thedarknet/dc26-badge/README.md

# dc26-badge
Darknet Industries Badge for Defcon 26

Firmware directory has STM32 and ESP32 firmware

hardware has:

* Darknet dc 26 eagle component library library
* Eagle files for board design
* docs for all components on the board plus a number of others that were considered
