thedarknet/dc26-badge/hardware/devboard/dc26-dev-board/README.md

The darknet board for 2018 (darknet-7) was dc26.brd/sch.
* Things I have not fixed yet:
 * The standard 3mm LEDs are backwards.
