thedarknet/dc26-badge/firmware/esp-wroom-32/dc26-esp/README.md

### DarkNet 7 ESP WROOM 32 code

First thing is to thank nkolban for his book, for his great code snippets.
https://github.com/nkolban/esp32-snippets.git

If you working on ESP get his book:  https://leanpub.com/kolban-ESP32
