thedarknet/dc26-badge/firmware/DevBoard/darknet-7/chipinfo.txt

> flash info 0
device id = 0x10006431
flash size = 512kbytes
#0 : stm32f2x at 0x08000000, size 0x00080000, buswidth 0, chipwidth 0
        #  0: 0x00000000 (0x4000 16kB) not protected
        #  1: 0x00004000 (0x4000 16kB) not protected
        #  2: 0x00008000 (0x4000 16kB) not protected
        #  3: 0x0000c000 (0x4000 16kB) not protected
        #  4: 0x00010000 (0x10000 64kB) not protected
        #  5: 0x00020000 (0x20000 128kB) not protected
        #  6: 0x00040000 (0x20000 128kB) not protected
        #  7: 0x00060000 (0x20000 128kB) not protected
STM32F4xx (Low Power) - Rev: A
