thedarknet/dc26-badge/firmware/DevBoard/darknet-7/Src/darknet/art/dc_zia_128-sized.png

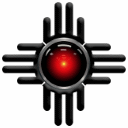
firmware/DevBoard/darknet-7/Src/darknet/art/dc_zia_128-sized.png
