thedarknet/dc26-badge/firmware/DevBoard/darknet-7/Src/darknet/art/TITS.png

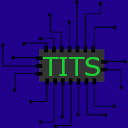
firmware/DevBoard/darknet-7/Src/darknet/art/TITS.png
