thedarknet/dc26-badge/firmware/esp-wroom-32/dc26-esp/main/dc26_ble/ESP WROOM 32-Interaction.png

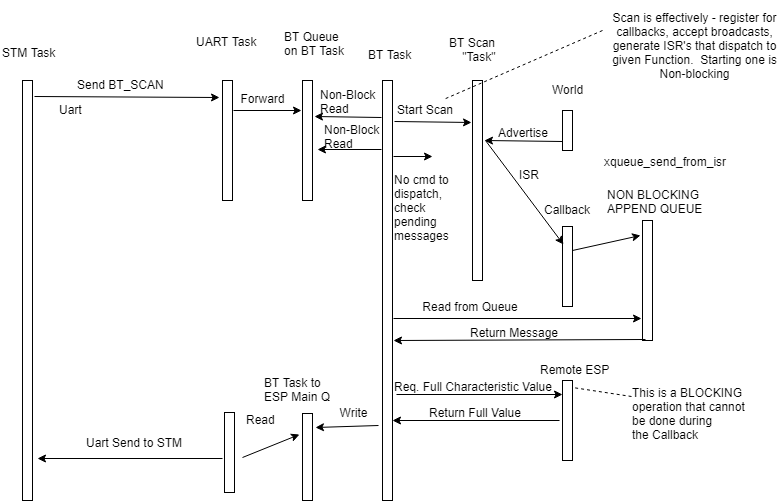
firmware/esp-wroom-32/dc26-esp/main/dc26_ble/ESP WROOM 32-Interaction.png
