thedarknet/dc26-badge/hardware/docs/led-symbols.jpg

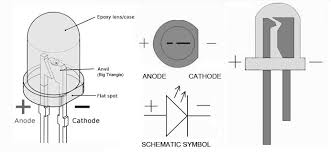
hardware/docs/led-symbols.jpg
