thedarknet/dc26-badge/hardware/docs/LEDs-2.PNG

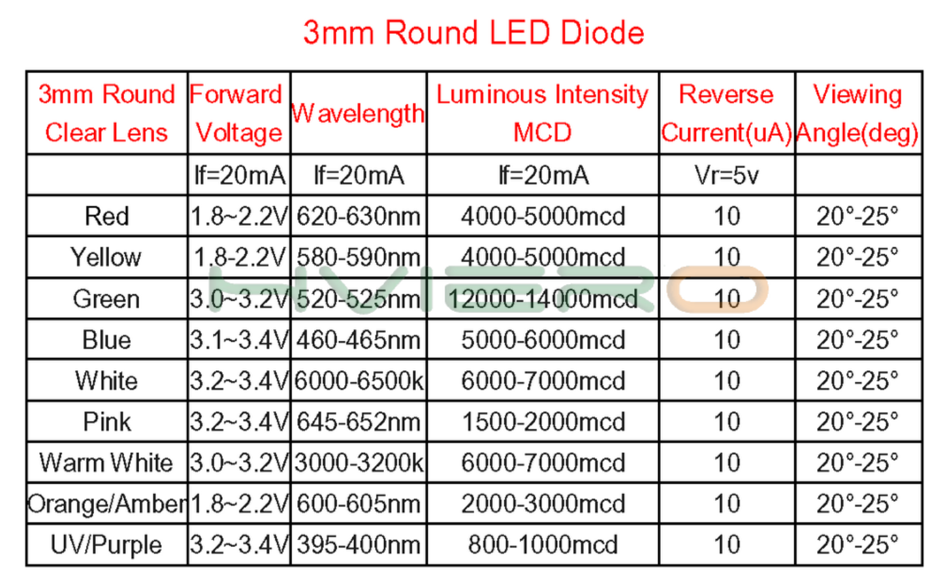
hardware/docs/LEDs-2.PNG
