thedarknet/dc26-badge/hardware/docs/LEDs.PNG

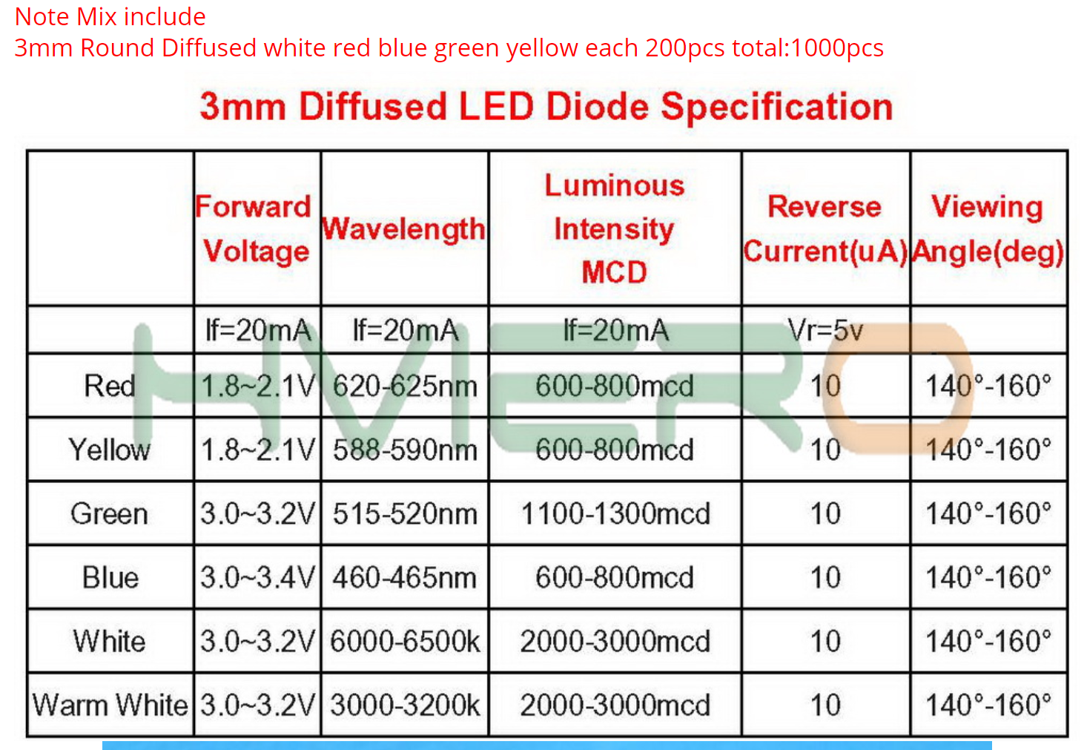
hardware/docs/LEDs.PNG
