thedarknet/dc26-badge/hardware/docs/SSSS8 Series - Basic information_files/Reel38_W.GIF

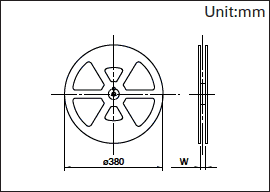
hardware/docs/SSSS8 Series - Basic information_files/Reel38_W.GIF
