thedarknet/dc26-badge/hardware/docs/SSSS8 Series - Basic information_files/SLIDE_H.GIF

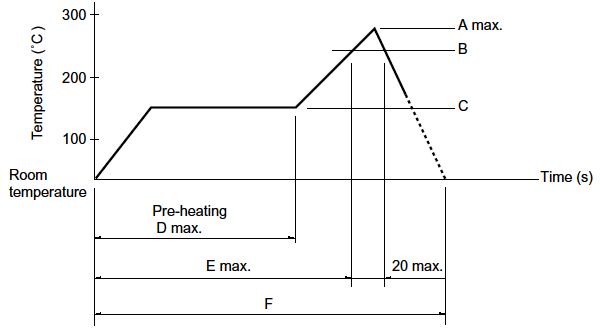
hardware/docs/SSSS8 Series - Basic information_files/SLIDE_H.GIF
