thedarknet/dc26-badge/hardware/docs/SSSS8 Series - Basic information_files/SSSS8_D_31.GIF

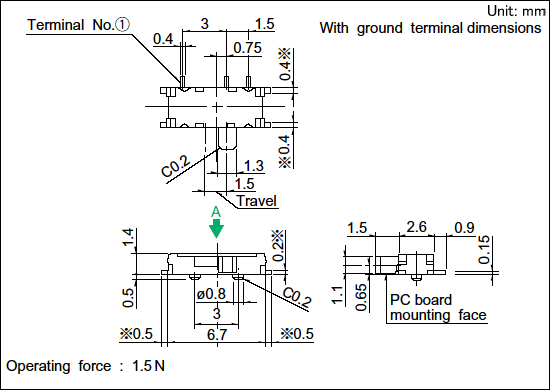
hardware/docs/SSSS8 Series - Basic information_files/SSSS8_D_31.GIF
