thedarknet/dc26-badge/hardware/docs/SSSS8 Series - Basic information_files/SSSS8_D_32.GIF

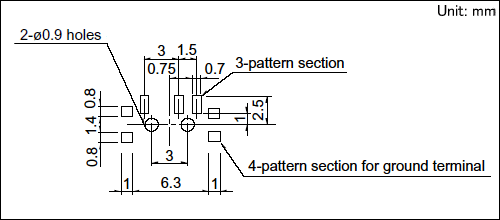
hardware/docs/SSSS8 Series - Basic information_files/SSSS8_D_32.GIF
