thedarknet/dc26-badge/hardware/docs/SSSS8 Series - Basic information_files/SSSS811101.jpg

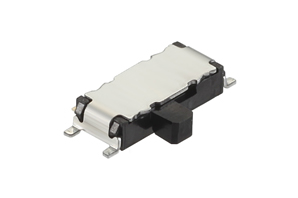
hardware/docs/SSSS8 Series - Basic information_files/SSSS811101.jpg
