thedarknet/dc26-badge/hardware/dc26-sao/eggplant/eggplant-BOM.xls

Sheet: 1
No. | part number/description | Package | Value | Qty | RefDefs | Note | 200sets
1 | ATTINY85-20SUR | SO08-EIAJ |  | 1 | U1 |  | $1.265
2 |  | R-EU_R0603_5MIL_DWS | 10K/5% | 3 | R2, R3, R5 |  | $0.009 | Provide general resistor 10K 0603 1%
3 |  | R-EU_R0805_5MIL_DWS | 0 | 2 | R1, R4 |  | $0.009 | Provide general resistor 0.2R 0805 1%
4 |  | R-EU_R0603_5MIL_DWS | 22/5% | 10 | R6, R7, R8, R9, R10, R11, R12, R13, R14, R15 |  | $0.009 | Provide general resistor 22R 0603 1%
5 | PHBM2012QBDSURKC | 0805 |  | 5 | LED1, LED2, LED3, LED4, LED5
 |  |  |  |  |  |  | 0.5KG
 |  |  |  |  | Total: | 1 set | $1.40
 |  |  |  |  |  | 200 sets | $279.4
 | PCBWay PCB Assembly Service

Sheet: Sheet1
U2 MT9V022I77ATM_ES@IBGA-52
U1 EMP7032SLC44-15@TQFP12FL12-44
J2 HEADER_13X2@CON26
J1 DOWNCABLE@CON10
X1 OSC@KDS-OSC-2025
C2 CAP_NP@CAP0402
C3 CAP_NP@CAP0402
C8 CAP_NP@CAP0402
C5 CAP_NP@CAP0402
C6 CAP_NP@CAP0402
C7 CAP_NP@CAP0402
C10 CAP_NP@CAP0402
C9 CAP_NP@CAP0402
C11 CAPACITOR_POL@SMC3528
C12 CAPACITOR_POL@SMC3528
L3 INDUCTOR@SMC0603
L2 INDUCTOR@SMC0603
C1 CAP_NP@CAP0402
L1 INDUCTOR@SMC0603
C4 CAP_NP@CAP0402
U3 COMPONENT_1@SOT23-5
C15 1-CAP-POL-MY@SMC3528
C16 1-CAP-POL-MY@SMC3528
R1 R@RES0402
R2 R@RES0402
C13 CAPACITOR_POL@SMC3528
U4 COMPONENT_1@SOT23-5
C19 1-CAP-POL-MY@SMC3528
C20 1-CAP-POL-MY@SMC3528
C14 CAP_NP@CAP0402
C17 CAP_NP@CAP0402
C22 CAP_NP@CAP0402
C18 CAP_NP@CAP0402
C21 CAP_NP@CAP0402
C23 CAP_NP@CAP0402
R3 R@RES0402
R4 R@RES0402
