thedarknet/dc26-badge/hardware/dc26-lbr/LDL112D33R/3D/LDL112D33R.stp

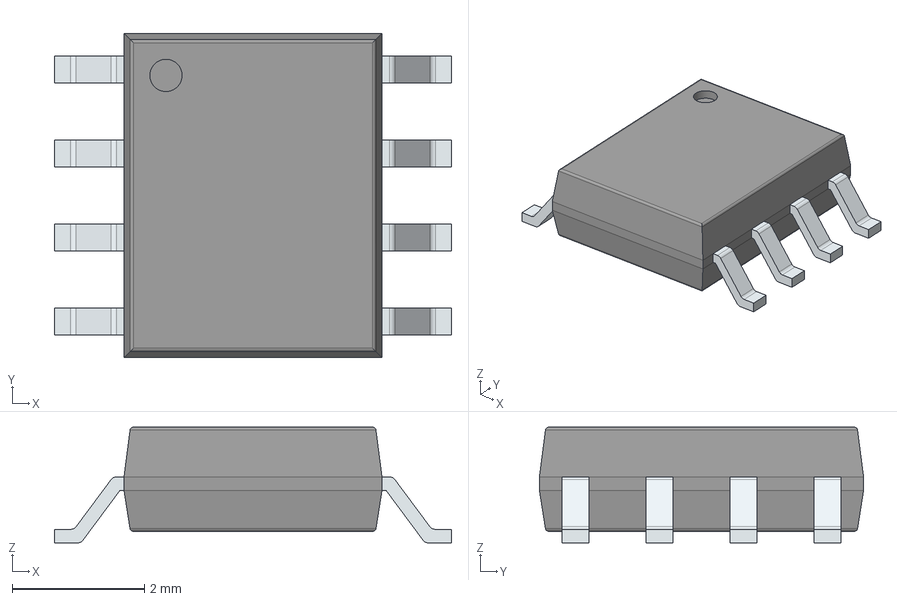
[picture p15: CAD file, 2018-04-17]
hardware/dc26-lbr/LDL112D33R/3D/LDL112D33R.stp
6.00 x 4.90 x 1.75 mm
PinsArrayLR
