thedarknet/dc26-badge/hardware/dc26-lbr/LIB_BLM18TG221TN1D/BLM18TG221TN1D/3D/BLM18TG221TN1D.stp

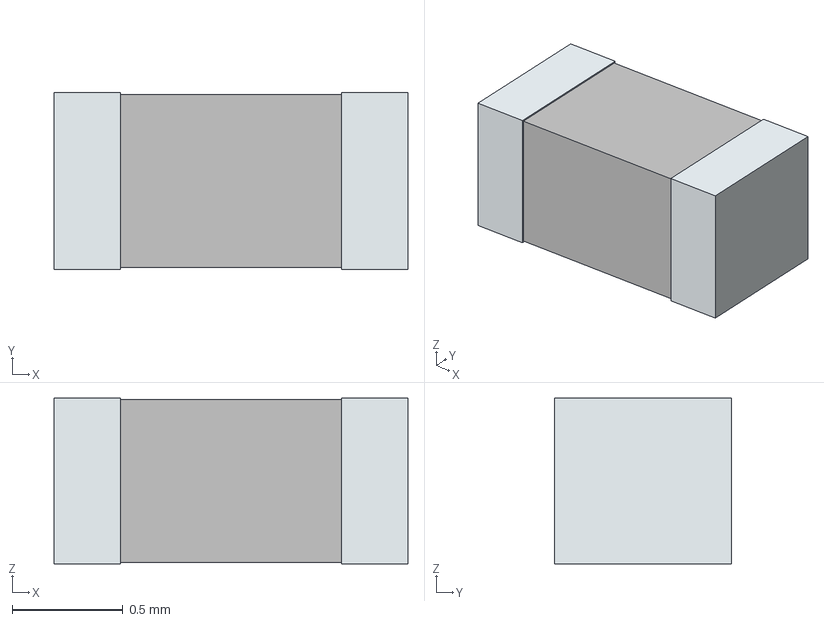
[picture p16: CAD file, 2017-12-29]
hardware/dc26-lbr/LIB_BLM18TG221TN1D/BLM18TG221TN1D/3D/BLM18TG221TN1D.stp
1.60 x 0.8 x 0.75 mm
term1
term2
