thedarknet/dc26-badge/hardware/dc26-lbr/LIB_STM32F411RET6/STM32F411RET6/3D/STM32F411RET6.stp

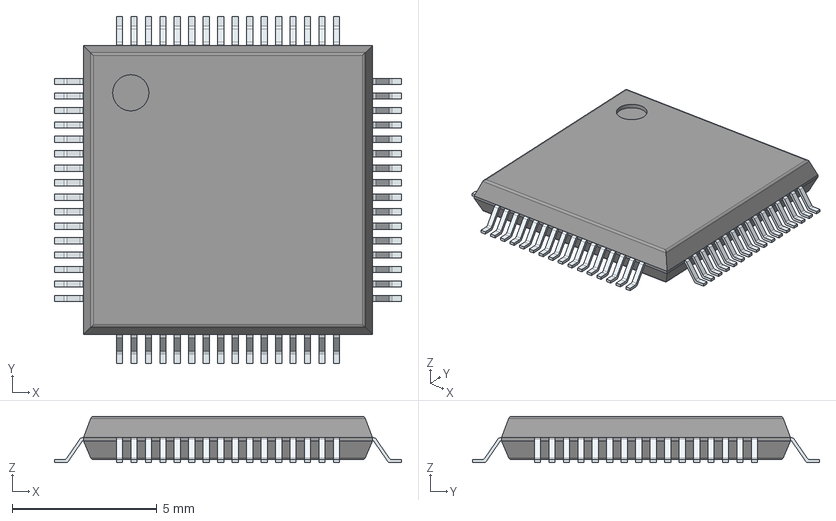
[picture p17: CAD file, 2017-12-07]
hardware/dc26-lbr/LIB_STM32F411RET6/STM32F411RET6/3D/STM32F411RET6.stp
12.0 x 12.0 x 1.60 mm
PinsArrayLR
PinsArrayTB
