thedarknet/dc26-badge/hardware/dc26-lbr/LIB_LD39050PU33R/LD39050PU33R/3D/LD39050PU33R.stp

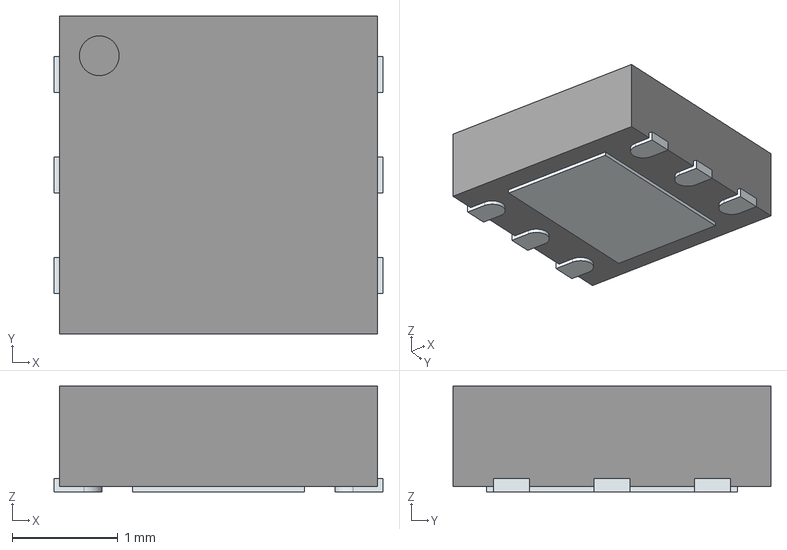
[picture p18: CAD file, 2017-12-31]
hardware/dc26-lbr/LIB_LD39050PU33R/LD39050PU33R/3D/LD39050PU33R.stp
3.10 x 3.00 x 1.00 mm
ThermalPin
PinsArrayLR
