thedarknet/dc26-badge/hardware/dc26-lbr/LIB_LD39100PU33RY/LD39100PU33RY/3D/LD39100PU33RY.stp

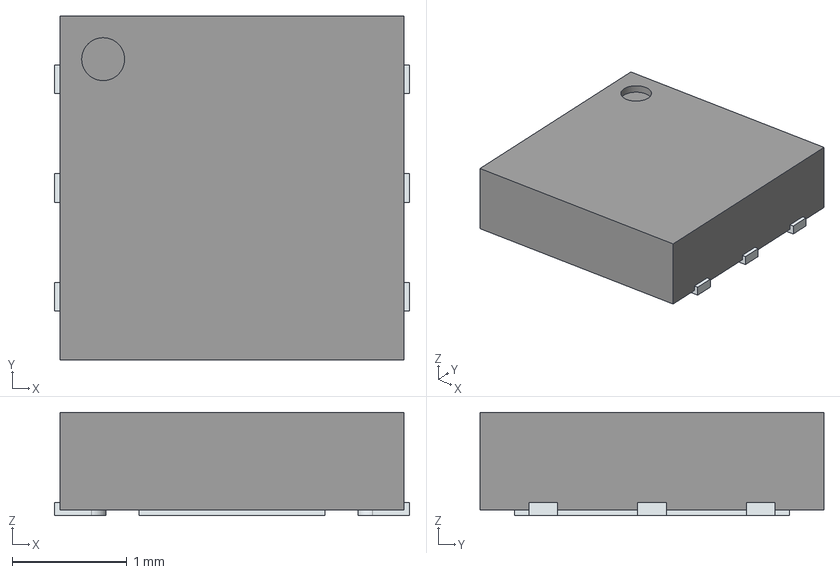
[picture p19: CAD file, 2018-01-01]
hardware/dc26-lbr/LIB_LD39100PU33RY/LD39100PU33RY/3D/LD39100PU33RY.stp
3.10 x 3.00 x 0.9 mm
ThermalPin
PinsArrayLR
