thedarknet/dc26-badge/(list of files, cad)

Other CAD files:
hardware/dc26-lbr/LDL112D33R/3D/LDL112D33R.stl
hardware/dc26-lbr/LIB_BLM18TG221TN1D/BLM18TG221TN1D/3D/BLM18TG221TN1D.stl
hardware/dc26-lbr/LIB_LD39050PU33R/LD39050PU33R/3D/LD39050PU33R.stl
hardware/dc26-lbr/LIB_LD39100PU33RY/LD39100PU33RY/3D/LD39100PU33RY.stl
hardware/dc26-lbr/LIB_STM32F411RET6/STM32F411RET6/3D/STM32F411RET6.stl
