thedarknet/dc26-badge/hardware/dc26-sao/eggplant/eggplant.brd

## EAGLE design hardware/dc26-sao/eggplant/eggplant.brd (2018-07-22)

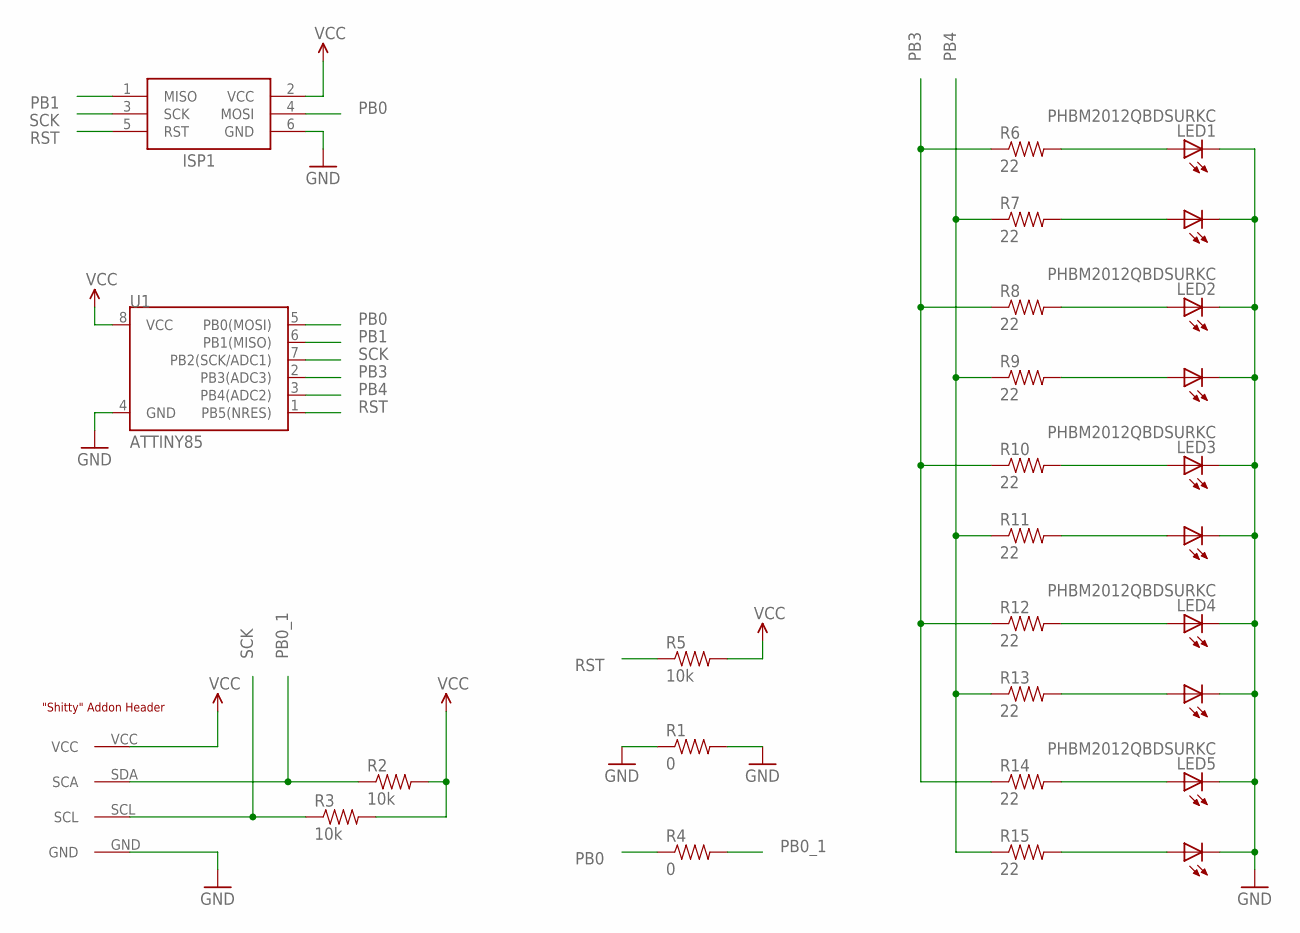
[picture p20: schematic eggplant.sch]

Parts:
ISP1: AVRISPPOGO; AVRISP-POGO
LED1, LED2, LED3, LED4, LED5: PHBM2012QBDSURKC; 0805-DUALLED
R1, R4: 0; 0805
R2, R3, R5: 10k; 0603-RES
R6, R7, R8, R9, R10, R11, R12, R13, R14, R15: 22; 0603-RES
U1: ATTINY85; SO08-EIAJ
U$1: ADDONSC_ADDON_SMD; SC_ADDON_SMD

Connections:
GND: ISP1.6 (GND), LED1.CB (C1), LED1.CR (C2), LED2.CB (C1), LED2.CR (C2), LED3.CB (C1), LED3.CR (C2), LED4.CB (C1), LED4.CR (C2), LED5.CB (C1), LED5.CR (C2), R1.1, R1.2, U1.4 (GND), U$1.GND
unnamed: LED1.AB (A1), R6.2
unnamed: LED1.AR (A2), R7.2
unnamed: LED2.AB (A1), R8.2
unnamed: LED2.AR (A2), R9.2
unnamed: LED3.AB (A1), R10.2
unnamed: LED3.AR (A2), R11.2
unnamed: LED4.AB (A1), R12.2
unnamed: LED4.AR (A2), R13.2
unnamed: LED5.AB (A1), R14.2
unnamed: LED5.AR (A2), R15.2
PB0: ISP1.4 (MOSI), R4.1, U1.5 (PB0(MOSI))
PB0_1: R2.1, R4.2, U$1.SDA (SCA)
PB1: ISP1.1 (MISO), U1.6 (PB1(MISO))
PB3: R6.1, R8.1, R10.1, R12.1, R14.1, U1.2 (PB3(ADC3))
PB4: R7.1, R9.1, R11.1, R13.1, R15.1, U1.3 (PB4(ADC2))
RST: ISP1.5 (RST), R5.1, U1.1 (PB5(NRES))
SCK: ISP1.3 (SCK), R3.1, U1.7 (PB2(SCK/ADC1)), U$1.SCL
VCC: ISP1.2 (VCC), R2.2, R3.2, R5.2, U1.8 (VCC), U$1.VCC

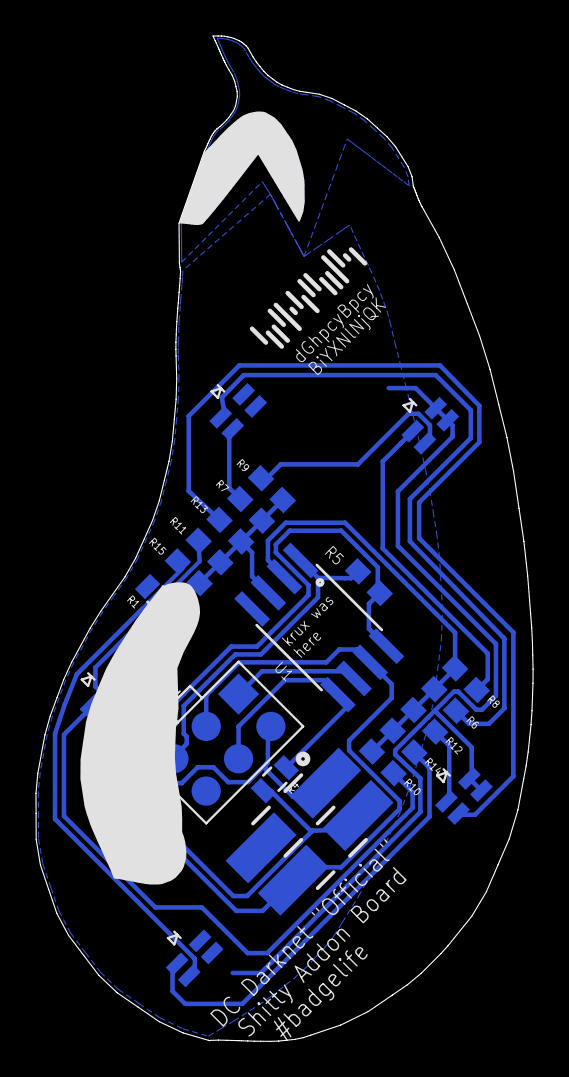
[picture p21: board eggplant.brd from below]

Board: 2 copper layers, 27.6 x 55.9 mm, 23 parts (22 on the bottom side), 19 nets.
