thedarknet/dc26-badge/hardware/devboard/dc26-dev-board/dc26.brd

## EAGLE design hardware/devboard/dc26-dev-board/dc26.brd (2018-06-18)

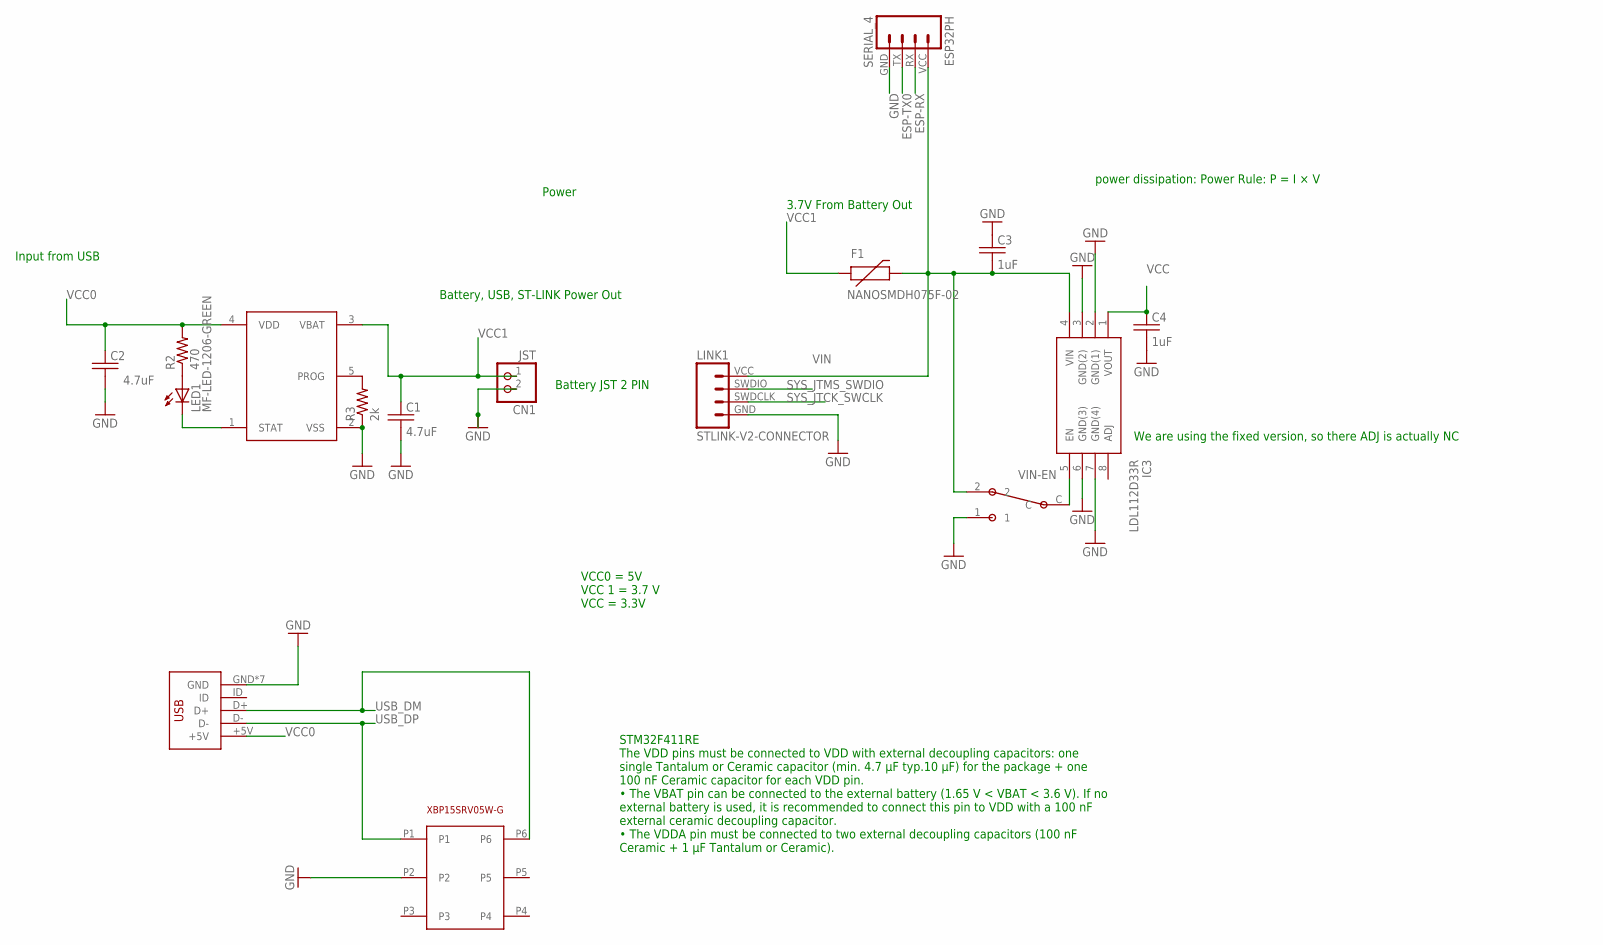
[picture p22: schematic dc26.sch, sheet 1]

Parts:
C1, C2: 4.7uF; C0805
C3, C4: 1uF; C0805
CHARGE: MCP73831; SOT23-5
CN1: JST; JST-PH-2-THM-RA
ESP32PH: SERIAL_4; SERIAL_HEADER_4
F1: NANOSMDH075F-02; PTC-1206
IC3: LDL112D33R; SOIC127P600X175-8N
LED1: MF-LED-1206-GREEN; LED-1206
LINK1: STLINK-V2-CONNECTOR; 1X04
P1: SPDT_SSAJ120100
R2: 470; 0805
R3: 2k; 0805
U$17: XBP15SRV05W-G; SOT-26P-XBP15SRV05W-G
USB: DX4R005JJ2DX4R005JJ2; DX4R005JJ2

Connections:
ESP-RX: ESP32PH.RX; also elsewhere on the board
ESP-TX0: ESP32PH.TX; also elsewhere on the board
GND: C1.2, C2.2, C3.1, C4.2, CHARGE.2 (VSS), CN1.2 (1), ESP32PH.GND, IC3.2 (GND(1)), IC3.3 (GND(2)), IC3.6 (GND(3)), IC3.7 (GND(4)), LINK1.GND, P1.1, R3.1, U$17.P2, USB.GND, USB.P$6 (GND), USB.P$7 (GND), USB.P$8 (GND), USB.P$9 (GND), USB.P$10 (GND), USB.P$11 (GND); also elsewhere on the board
unnamed: LED1.A, R2.1
unnamed: CHARGE.5 (PROG), R3.2
unnamed: CHARGE.1 (STAT), LED1.C
SYS_JTCK_SWCLK: LINK1.SWDCLK; also elsewhere on the board
SYS_JTMS_SWDIO: LINK1.SWDIO; also elsewhere on the board
USB_DM: U$17.P6, USB.D+; also elsewhere on the board
USB_DP: U$17.P1, USB.D-; also elsewhere on the board
VCC: C4.1, IC3.1 (VOUT); also elsewhere on the board
VCC0: C2.1, CHARGE.4 (VDD), R2.2, USB.+5V
VCC1: C1.1, CHARGE.3 (VBAT), CN1.1 (2), F1.1; also elsewhere on the board
VIN: C3.2, ESP32PH.VCC, F1.2, IC3.4 (VIN), LINK1.VCC, P1.2; also elsewhere on the board
VIN-EN: IC3.5 (EN), P1.C; also elsewhere on the board

Notes on the sheet:
Input from USB
Battery JST 2 PIN
Battery, USB, ST-LINK Power Out
power dissipation: Power Rule: P = I × V
3.7V From Battery Out
VCC0 = 5V VCC 1 = 3.7 V VCC = 3.3V
Power
STM32F411RE The VDD pins must be connected to VDD with external decoupling capacitors: one single Tantalum or Ceramic capacitor (min. 4.7 μF typ.10 μF) for the package + one 100 nF Ceramic capacitor for each VDD pin. • The VBAT pin can be connected to the external battery (1.65 V < VBAT < 3.6 V). I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
We are using the fixed version, so there ADJ is actually NC

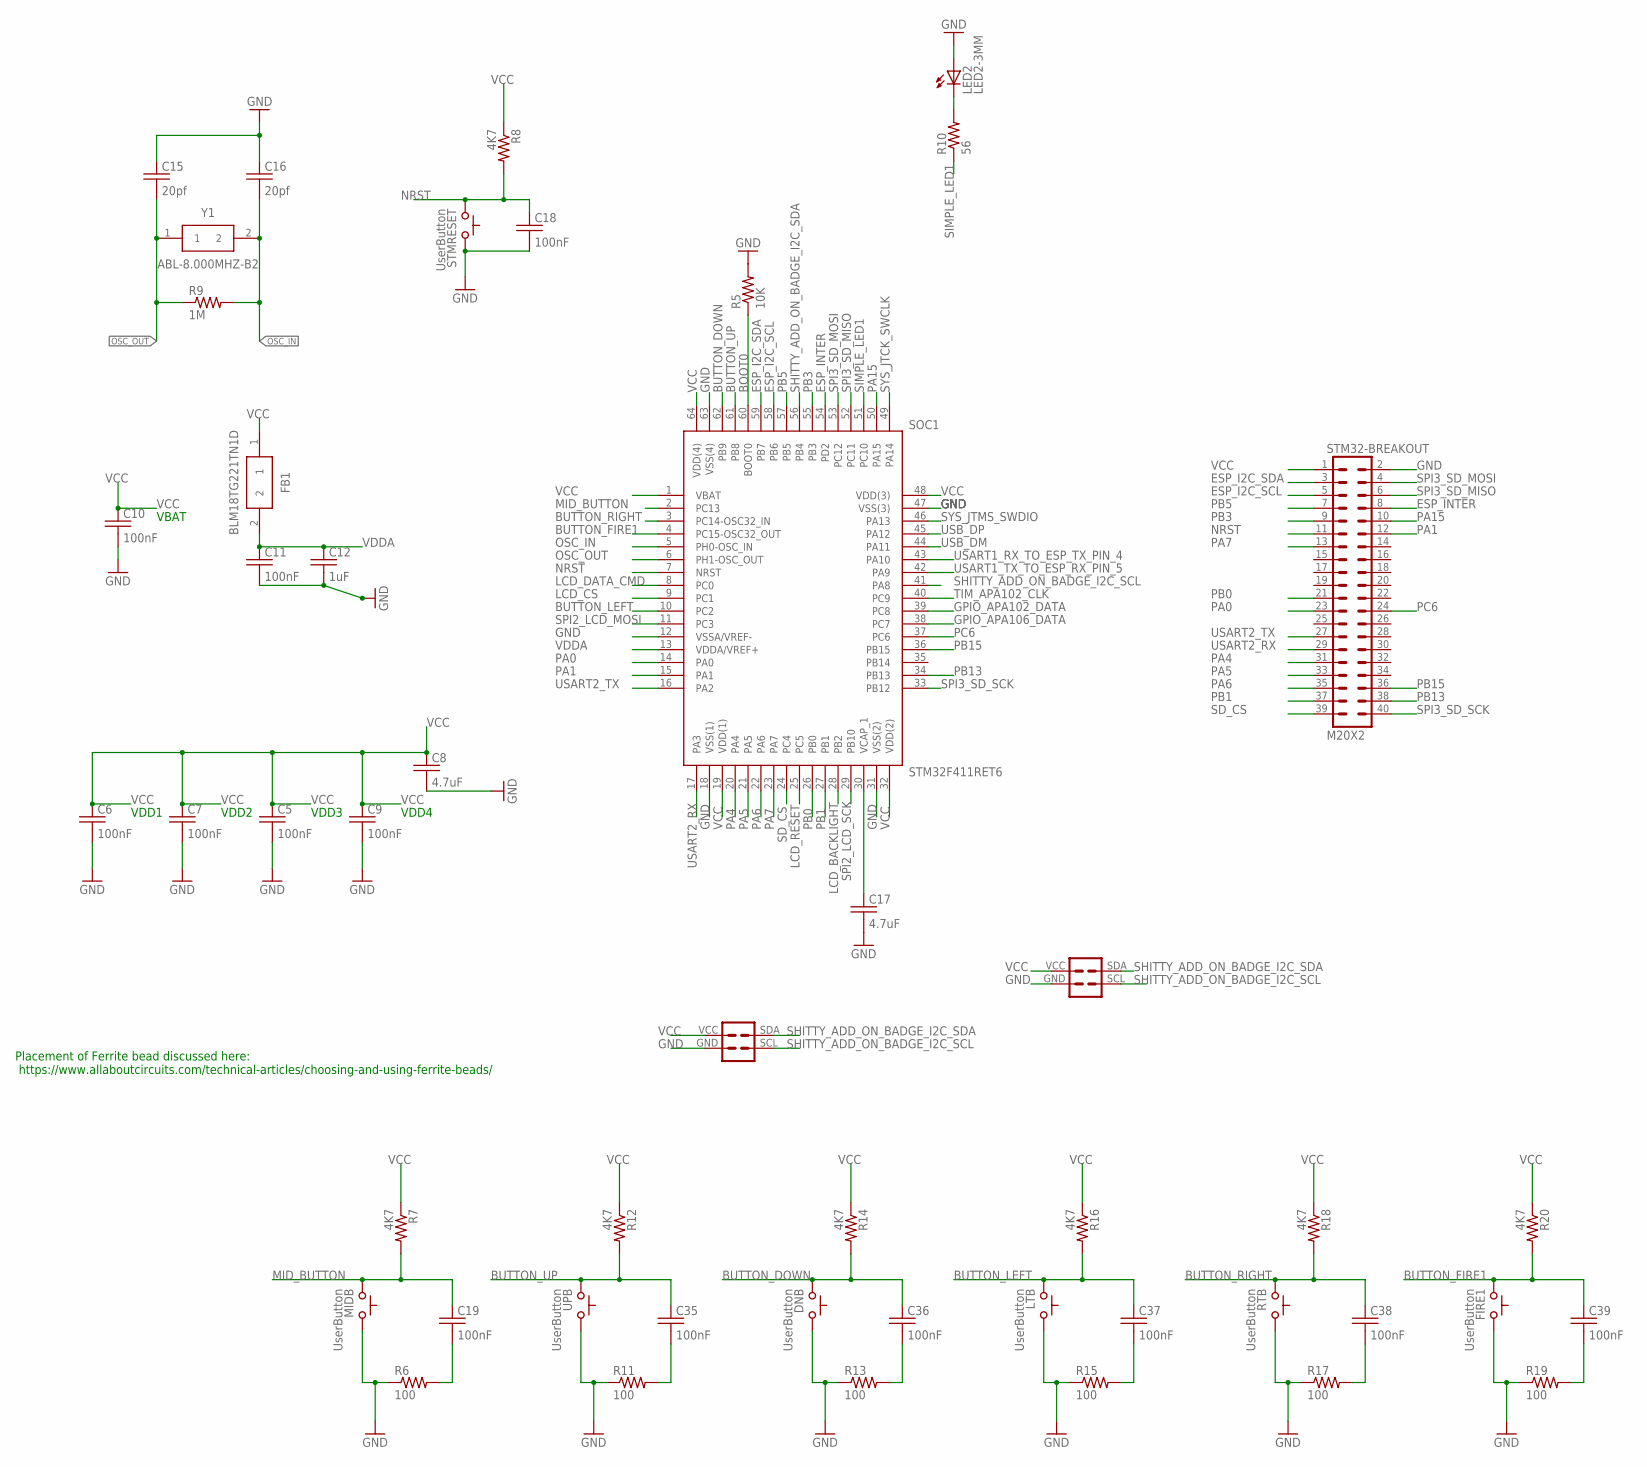
[picture p23: schematic dc26.sch, sheet 2]

Parts:
C5, C6, C7, C9, C10, C11, C18, C19, C35, C36, C37, C38, C39: 100nF; C0805
C8, C17: 4.7uF; C0805
C12: 1uF; C0805
C15, C16: 20pf; C0805
DNB: UserButton; TACTILE-2PIN-NARROW
FB1: BLM18TG221TN1D; BEADC1608X75N
FIRE1: UserButton; TACTILE-2PIN-NARROW
J1, J2: DC26 Shitty AddOn; DC26SHITTY_ADDON_CONNECTOR
LED2: LED2-3MM; LED3MM
LTB: UserButton; TACTILE-2PIN-NARROW
MIDB: UserButton; TACTILE-2PIN-NARROW
R5: 10K; 0805
R6, R11, R13, R15, R17, R19: 100; 0805
R7, R8, R12, R14, R16, R18, R20: 4K7; 0805
R9: 1M; 0805
R10: 56; 0805
RTB: UserButton; TACTILE-2PIN-NARROW
SOC1: STM32F411RET6; QFP50P1200X1200X160-64N
STM32-BREAKOUT: M20X2; 2X20
STMRESET: UserButton; TACTILE-2PIN-NARROW
UPB: UserButton; TACTILE-2PIN-NARROW
Y1: ABL-8.000MHZ-B2; HC/49US_(AT49)PTH

Connections:
BOOT0: R5.1, SOC1.60 (BOOT0)
BUTTON_DOWN: C36.1, DNB.P$2 (C), R14.2, SOC1.62 (PB9)
BUTTON_FIRE1: C39.1, FIRE1.P$2 (C), R20.2, SOC1.4 (PC15-OSC32_OUT)
BUTTON_LEFT: C37.1, LTB.P$2 (C), R16.2, SOC1.10 (PC2)
BUTTON_RIGHT: C38.1, R18.2, RTB.P$2 (C), SOC1.3 (PC14-OSC32_IN)
BUTTON_UP: C35.1, R12.2, SOC1.61 (PB8), UPB.P$2 (C)
ESP_I2C_SCL: SOC1.58 (PB6), STM32-BREAKOUT.5; also elsewhere on the board
ESP_I2C_SDA: SOC1.59 (PB7), STM32-BREAKOUT.3; also elsewhere on the board
ESP_INTER: SOC1.54 (PD2), STM32-BREAKOUT.8; also elsewhere on the board
GND: C5.2, C6.2, C7.2, C8.2, C9.2, C10.2, C11.2, C12.2, C15.1, C16.1, C17.2, C18.2, DNB.P$1 (A), FIRE1.P$1 (A), J1.GND, J2.GND, LED2.A, LTB.P$1 (A), MIDB.P$1 (A), R5.2, R6.1, R11.1, R13.1, R15.1, R17.1, R19.1, RTB.P$1 (A), SOC1.12 (VSSA/VREF-), SOC1.18 (VSS(1)), SOC1.31 (VSS(2)), SOC1.47 (VSS(3)), SOC1.63 (VSS(4)), STM32-BREAKOUT.2, STMRESET.P$1 (A), UPB.P$1 (A); also elsewhere on the board
GPIO_APA102_DATA: SOC1.39 (PC8); also elsewhere on the board
GPIO_APA106_DATA: SOC1.38 (PC7); also elsewhere on the board
LCD_BACKLIGHT: SOC1.28 (PB2); also elsewhere on the board
LCD_CS: SOC1.9 (PC1); also elsewhere on the board
LCD_DATA_CMD: SOC1.8 (PC0); also elsewhere on the board
LCD_RESET: SOC1.25 (PC5); also elsewhere on the board
MID_BUTTON: C19.1, MIDB.P$2 (C), R7.2, SOC1.2 (PC13)
unnamed: C19.2, R6.2
unnamed: C17.1, SOC1.30 (VCAP_1)
unnamed: LED2.K (C), R10.2
unnamed: C35.2, R11.2
unnamed: C36.2, R13.2
unnamed: C37.2, R15.2
unnamed: C38.2, R17.2
unnamed: C39.2, R19.2
NRST: C18.1, R8.2, SOC1.7 (NRST), STM32-BREAKOUT.11, STMRESET.P$2 (C)
OSC_IN: C16.2, R9.2, SOC1.5 (PH0-OSC_IN), Y1.2
OSC_OUT: C15.2, R9.1, SOC1.6 (PH1-OSC_OUT), Y1.1
PA0: SOC1.14 (PA0), STM32-BREAKOUT.23
PA1: SOC1.15 (PA1), STM32-BREAKOUT.12
PA4: SOC1.20 (PA4), STM32-BREAKOUT.31
PA5: SOC1.21 (PA5), STM32-BREAKOUT.33
PA6: SOC1.22 (PA6), STM32-BREAKOUT.35
PA7: SOC1.23 (PA7), STM32-BREAKOUT.13
PA15: SOC1.50 (PA15), STM32-BREAKOUT.10
PB0: SOC1.26 (PB0), STM32-BREAKOUT.21
PB1: SOC1.27 (PB1), STM32-BREAKOUT.37
PB3: SOC1.55 (PB3), STM32-BREAKOUT.9
PB5: SOC1.57 (PB5), STM32-BREAKOUT.7
PB13: SOC1.34 (PB13), STM32-BREAKOUT.38
PB15: SOC1.36 (PB15), STM32-BREAKOUT.36
PC6: SOC1.37 (PC6), STM32-BREAKOUT.24
SD_CS: SOC1.24 (PC4), STM32-BREAKOUT.39; also elsewhere on the board
SHITTY_ADD_ON_BADGE_I2C_SCL: J1.SCL, J2.SCL, SOC1.41 (PA8)
SHITTY_ADD_ON_BADGE_I2C_SDA: J1.SDA, J2.SDA, SOC1.56 (PB4)
SIMPLE_LED1: R10.1, SOC1.51 (PC10)
SPI2_LCD_MOSI: SOC1.11 (PC3); also elsewhere on the board
SPI2_LCD_SCK: SOC1.29 (PB10); also elsewhere on the board
SPI3_SD_MISO: SOC1.52 (PC11), STM32-BREAKOUT.6; also elsewhere on the board
SPI3_SD_MOSI: SOC1.53 (PC12), STM32-BREAKOUT.4; also elsewhere on the board
SPI3_SD_SCK: SOC1.33 (PB12), STM32-BREAKOUT.40; also elsewhere on the board
SYS_JTCK_SWCLK: SOC1.49 (PA14); also elsewhere on the board
SYS_JTMS_SWDIO: SOC1.46 (PA13); also elsewhere on the board
TIM_APA102_CLK: SOC1.40 (PC9); also elsewhere on the board
USART1_RX_TO_ESP_TX_PIN_4: SOC1.43 (PA10); also elsewhere on the board
USART1_TX_TO_ESP_RX_PIN_5: SOC1.42 (PA9); also elsewhere on the board
USART2_RX: SOC1.17 (PA3), STM32-BREAKOUT.29
USART2_TX: SOC1.16 (PA2), STM32-BREAKOUT.27
USB_DM: SOC1.44 (PA11); also elsewhere on the board
USB_DP: SOC1.45 (PA12); also elsewhere on the board
VCC: C5.1, C6.1, C7.1, C8.1, C9.1, C10.1, FB1.1, J1.VCC, J2.VCC, R7.1, R8.1, R12.1, R14.1, R16.1, R18.1, R20.1, SOC1.1 (VBAT), SOC1.19 (VDD(1)), SOC1.32 (VDD(2)), SOC1.48 (VDD(3)), SOC1.64 (VDD(4)), STM32-BREAKOUT.1; also elsewhere on the board
VDDA: C11.1, C12.1, FB1.2, SOC1.13 (VDDA/VREF+)

Notes on the sheet:
Placement of Ferrite bead discussed here: https://www.allaboutcircuits.com/technical-articles/choosing-and-using-ferrite-beads/
VBAT
VDD1
VDD2
VDD3
VDD4

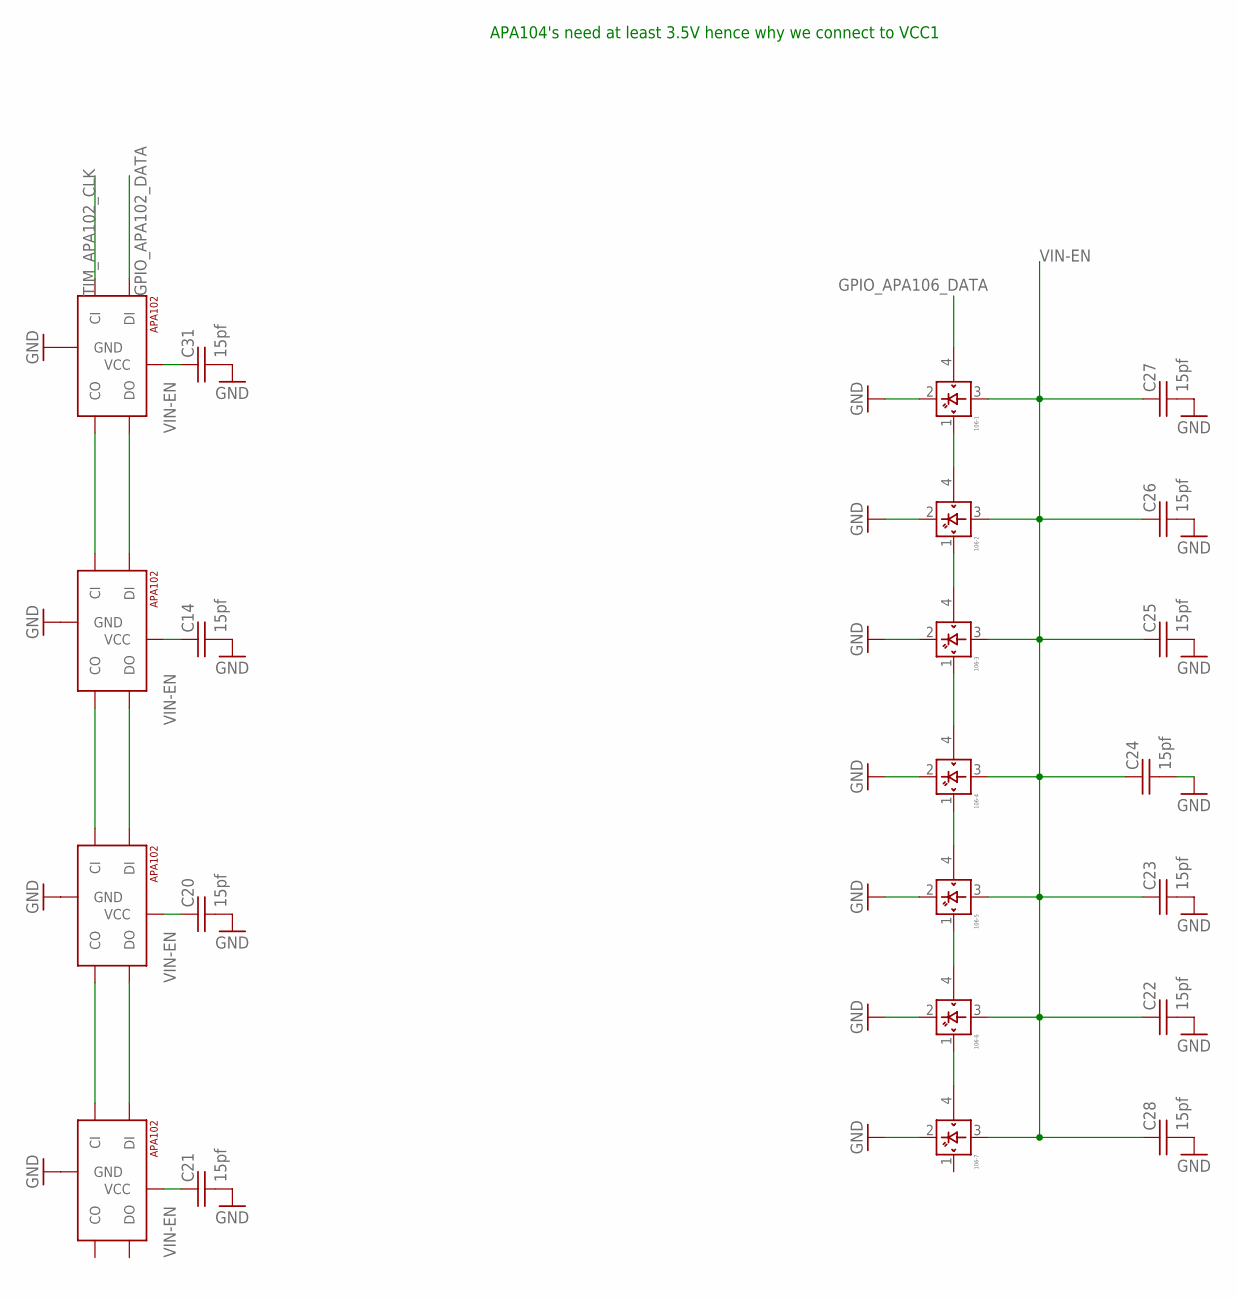
[picture p24: schematic dc26.sch, sheet 3]

Parts:
102-1, 102-2, 102-3, 102-4: APA1025050; APA102_5050
106-1, 106-2, 106-3, 106-4, 106-5, 106-6, 106-7: APA-106; WS2812F5_STRAIGHT
C14, C20, C21, C22, C23, C24, C25, C26, C27, C28, C31: 15pf; C0805

Connections:
GND: 102-1.6 (GND), 102-2.6 (GND), 102-3.6 (GND), 102-4.6 (GND), 106-1.2 (GND), 106-2.2 (GND), 106-3.2 (GND), 106-4.2 (GND), 106-5.2 (GND), 106-6.2 (GND), 106-7.2 (GND), C14.2, C20.2, C21.2, C22.2, C23.2, C24.2, C25.2, C26.2, C27.2, C28.2, C31.2; also elsewhere on the board
GPIO_APA102_DATA: 102-1.4 (DI); also elsewhere on the board
GPIO_APA106_DATA: 106-1.4 (DIN); also elsewhere on the board
unnamed: 102-1.2 (CO), 102-2.5 (CI)
unnamed: 102-2.2 (CO), 102-3.5 (CI)
unnamed: 102-3.2 (CO), 102-4.5 (CI)
unnamed: 102-3.3 (DO), 102-4.4 (DI)
unnamed: 102-2.3 (DO), 102-3.4 (DI)
unnamed: 102-1.3 (DO), 102-2.4 (DI)
unnamed: 106-1.1 (DOUT), 106-2.4 (DIN)
unnamed: 106-2.1 (DOUT), 106-3.4 (DIN)
unnamed: 106-3.1 (DOUT), 106-4.4 (DIN)
unnamed: 106-4.1 (DOUT), 106-5.4 (DIN)
unnamed: 106-5.1 (DOUT), 106-6.4 (DIN)
unnamed: 106-6.1 (DOUT), 106-7.4 (DIN)
TIM_APA102_CLK: 102-1.5 (CI); also elsewhere on the board
VIN-EN: 102-1.1 (VCC), 102-2.1 (VCC), 102-3.1 (VCC), 102-4.1 (VCC), 106-1.3 (VDD), 106-2.3 (VDD), 106-3.3 (VDD), 106-4.3 (VDD), 106-5.3 (VDD), 106-6.3 (VDD), 106-7.3 (VDD), C14.1, C20.1, C21.1, C22.1, C23.1, C24.1, C25.1, C26.1, C27.1, C28.1, C31.1; also elsewhere on the board

Notes on the sheet:
APA104's need at least 3.5V hence why we connect to VCC1

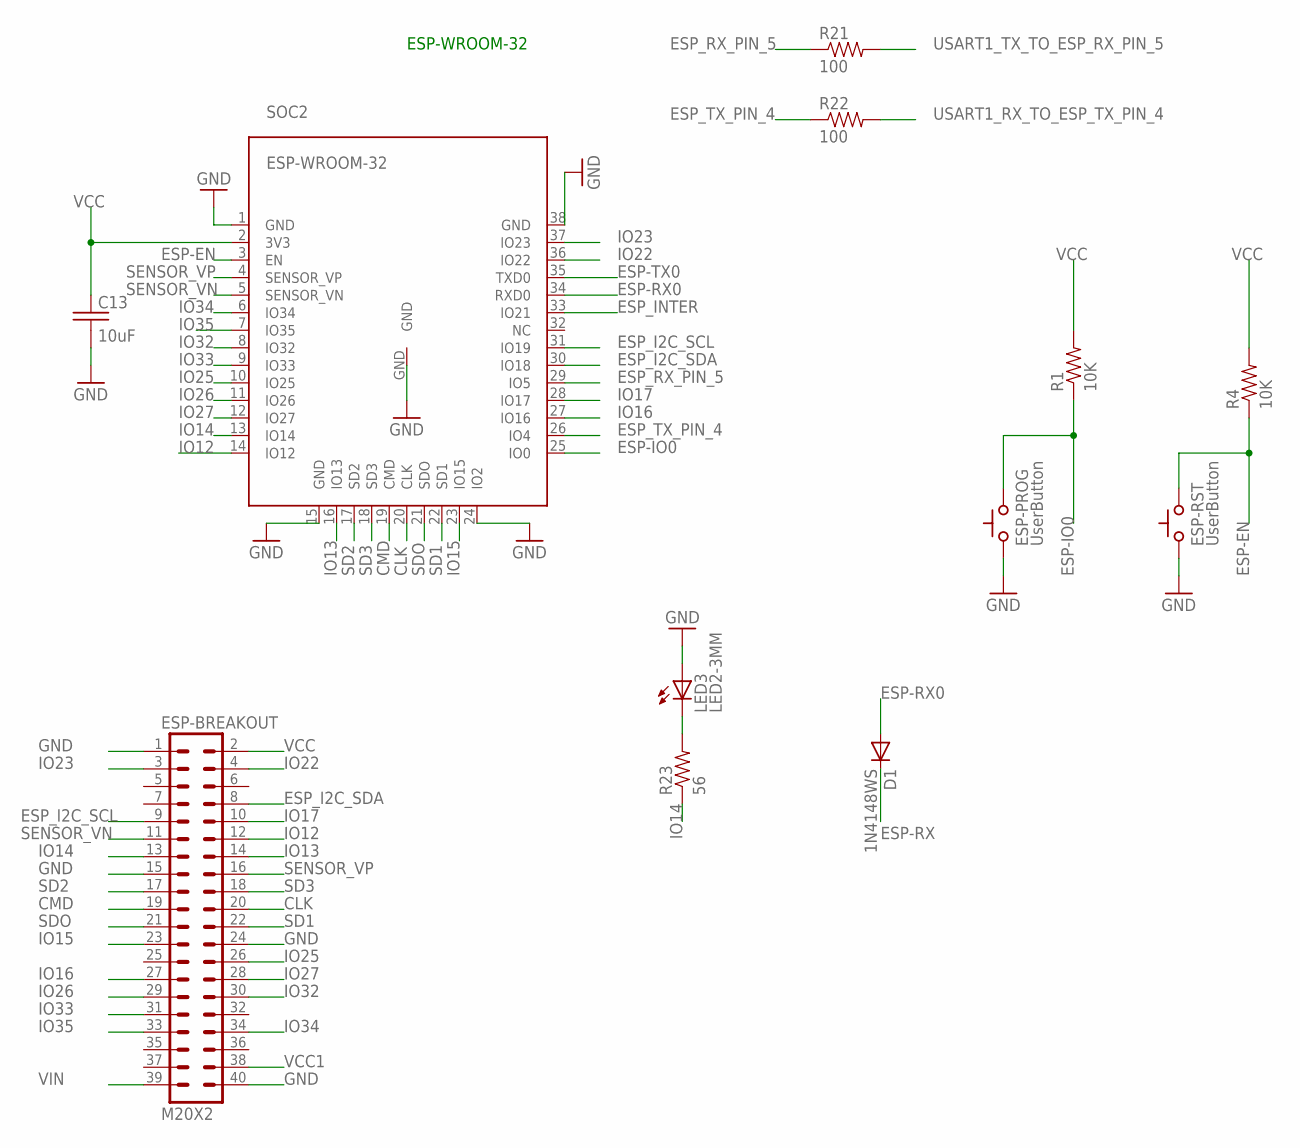
[picture p25: schematic dc26.sch, sheet 4]

Parts:
C13: 10uF; C0805
D1: 1N4148WS; SOD-323
ESP-BREAKOUT: M20X2; 2X20
ESP-PROG: UserButton; TACTILE-2PIN-NARROW
ESP-RST: UserButton; TACTILE-2PIN-NARROW
LED3: LED2-3MM; LED3MM
R1, R4: 10K; 0805
R21, R22: 100; 0805
R23: 56; 0805
SOC2: ESP-WROOM-32

Connections:
CLK: ESP-BREAKOUT.20, SOC2.20 (CLK)
CMD: ESP-BREAKOUT.19, SOC2.19 (CMD)
ESP-EN: ESP-RST.P$1 (A), R4.1, SOC2.3 (EN)
ESP-IO0: ESP-PROG.P$1 (A), R1.1, SOC2.25 (IO0)
ESP-RX: D1.1 (C); also elsewhere on the board
ESP-RX0: D1.2 (A), SOC2.34 (RXD0)
ESP-TX0: SOC2.35 (TXD0); also elsewhere on the board
ESP_I2C_SCL: ESP-BREAKOUT.9, SOC2.31 (IO19); also elsewhere on the board
ESP_I2C_SDA: ESP-BREAKOUT.8, SOC2.30 (IO18); also elsewhere on the board
ESP_INTER: SOC2.33 (IO21); also elsewhere on the board
ESP_RX_PIN_5: R21.1, SOC2.29 (IO5)
ESP_TX_PIN_4: R22.1, SOC2.26 (IO4)
GND: C13.2, ESP-BREAKOUT.1, ESP-BREAKOUT.15, ESP-BREAKOUT.24, ESP-BREAKOUT.40, ESP-PROG.P$2 (C), ESP-RST.P$2 (C), LED3.A, SOC2.1 (GND), SOC2.15 (GND), SOC2.24 (IO2), SOC2.38 (GND), SOC2.GND; also elsewhere on the board
IO12: ESP-BREAKOUT.12, SOC2.14 (IO12)
IO13: ESP-BREAKOUT.14, SOC2.16 (IO13)
IO14: ESP-BREAKOUT.13, R23.1, SOC2.13 (IO14)
IO15: ESP-BREAKOUT.23, SOC2.23 (IO15)
IO16: ESP-BREAKOUT.27, SOC2.27 (IO16)
IO17: ESP-BREAKOUT.10, SOC2.28 (IO17)
IO22: ESP-BREAKOUT.4, SOC2.36 (IO22)
IO23: ESP-BREAKOUT.3, SOC2.37 (IO23)
IO25: ESP-BREAKOUT.26, SOC2.10 (IO25)
IO26: ESP-BREAKOUT.29, SOC2.11 (IO26)
IO27: ESP-BREAKOUT.28, SOC2.12 (IO27)
IO32: ESP-BREAKOUT.30, SOC2.8 (IO32)
IO33: ESP-BREAKOUT.31, SOC2.9 (IO33)
IO34: ESP-BREAKOUT.34, SOC2.6 (IO34)
IO35: ESP-BREAKOUT.33, SOC2.7 (IO35)
unnamed: LED3.K (C), R23.2
SD1: ESP-BREAKOUT.22, SOC2.22 (SD1)
SD2: ESP-BREAKOUT.17, SOC2.17 (SD2)
SD3: ESP-BREAKOUT.18, SOC2.18 (SD3)
SDO: ESP-BREAKOUT.21, SOC2.21 (SDO)
SENSOR_VN: ESP-BREAKOUT.11, SOC2.5 (SENSOR_VN)
SENSOR_VP: ESP-BREAKOUT.16, SOC2.4 (SENSOR_VP)
USART1_RX_TO_ESP_TX_PIN_4: R22.2; also elsewhere on the board
USART1_TX_TO_ESP_RX_PIN_5: R21.2; also elsewhere on the board
VCC: C13.1, ESP-BREAKOUT.2, R1.2, R4.2, SOC2.2 (3V3); also elsewhere on the board
VCC1: ESP-BREAKOUT.38; also elsewhere on the board
VIN: ESP-BREAKOUT.39; also elsewhere on the board

Notes on the sheet:
ESP-WROOM-32

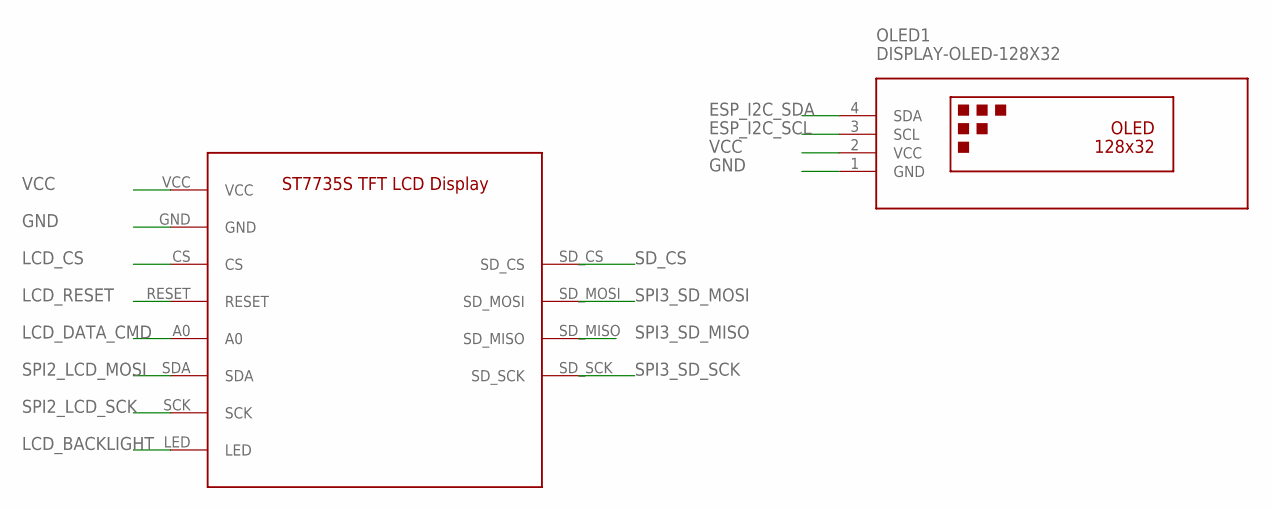
[picture p26: schematic dc26.sch, sheet 5]

Parts:
LCD1: ST7735S_LCD_MODULE; ST7735S_LCD_DISPLAY
OLED1: DISPLAY-OLED-128X32

Connections:
ESP_I2C_SCL: OLED1.3 (SCL); also elsewhere on the board
ESP_I2C_SDA: OLED1.4 (SDA); also elsewhere on the board
GND: LCD1.GND, OLED1.1 (GND); also elsewhere on the board
LCD_BACKLIGHT: LCD1.LED; also elsewhere on the board
LCD_CS: LCD1.CS; also elsewhere on the board
LCD_DATA_CMD: LCD1.A0; also elsewhere on the board
LCD_RESET: LCD1.RESET; also elsewhere on the board
SD_CS: LCD1.SD_CS; also elsewhere on the board
SPI2_LCD_MOSI: LCD1.SDA; also elsewhere on the board
SPI2_LCD_SCK: LCD1.SCK; also elsewhere on the board
SPI3_SD_MISO: LCD1.SD_MISO; also elsewhere on the board
SPI3_SD_MOSI: LCD1.SD_MOSI; also elsewhere on the board
SPI3_SD_SCK: LCD1.SD_SCK; also elsewhere on the board
VCC: LCD1.VCC, OLED1.2 (VCC); also elsewhere on the board

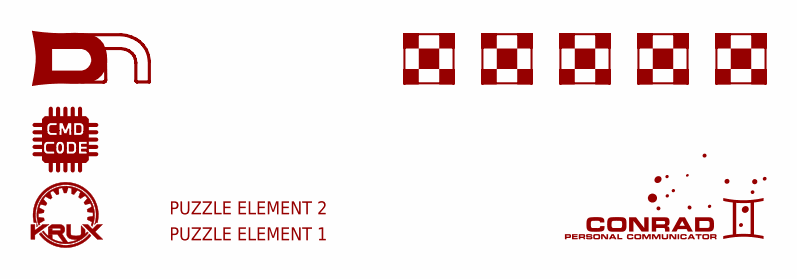
[picture p27: schematic dc26.sch, sheet 6]

Parts:
U$1: KRUX_LOGO
U$2: CMD_C0DE_LOGO
U$3: DC26_KRUX_PUZZLE_1; DN26_KRUX_PUZZLE_1
U$4: DC26_KRUX_PUZZLE_2; DN26_KRUX_PUZZLE_2
U$5: CONRAD_LOGO
U$6: DN_LOGODC26; DN_LOGO_DC26
U$7, U$8: FIDUCIAL_DNBOX; FIDUCIAL_BOX
U$9, U$10, U$11: FIDUCIAL_DNCORNER; FIDUCIAL_CORNER

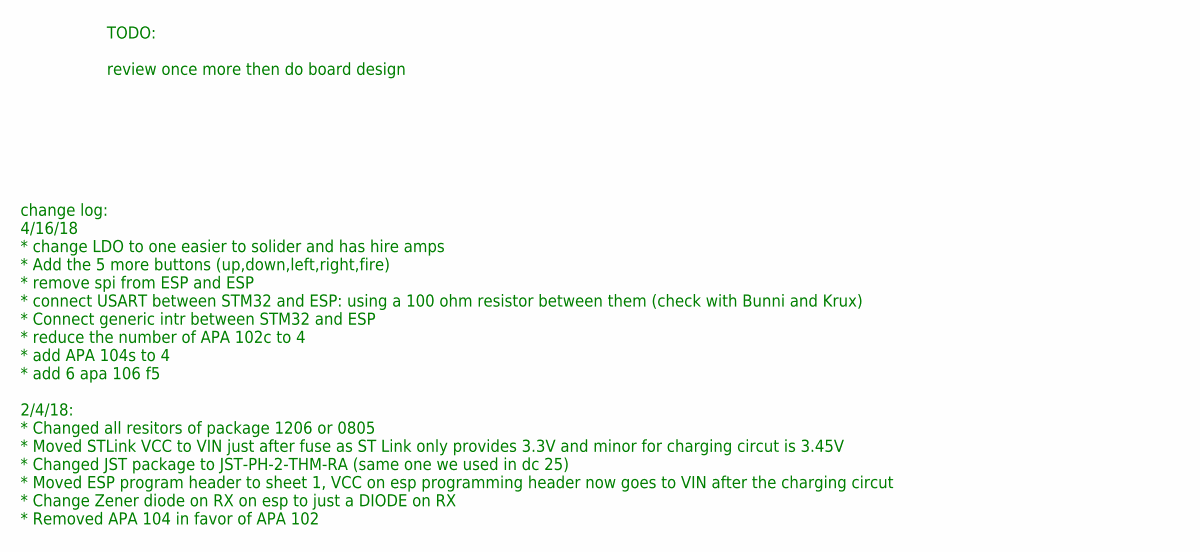
[picture p28: schematic dc26.sch, sheet 7]

Notes on the sheet:
change log: 4/16/18 * change LDO to one easier to solider and has hire amps * Add the 5 more buttons (up,down,left,right,fire) * remove spi from ESP and ESP * connect USART between STM32 and ESP: using a 100 ohm resistor between them (check with Bunni and Krux) * Connect generic intr between STM32 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
TODO: review once more then do board design

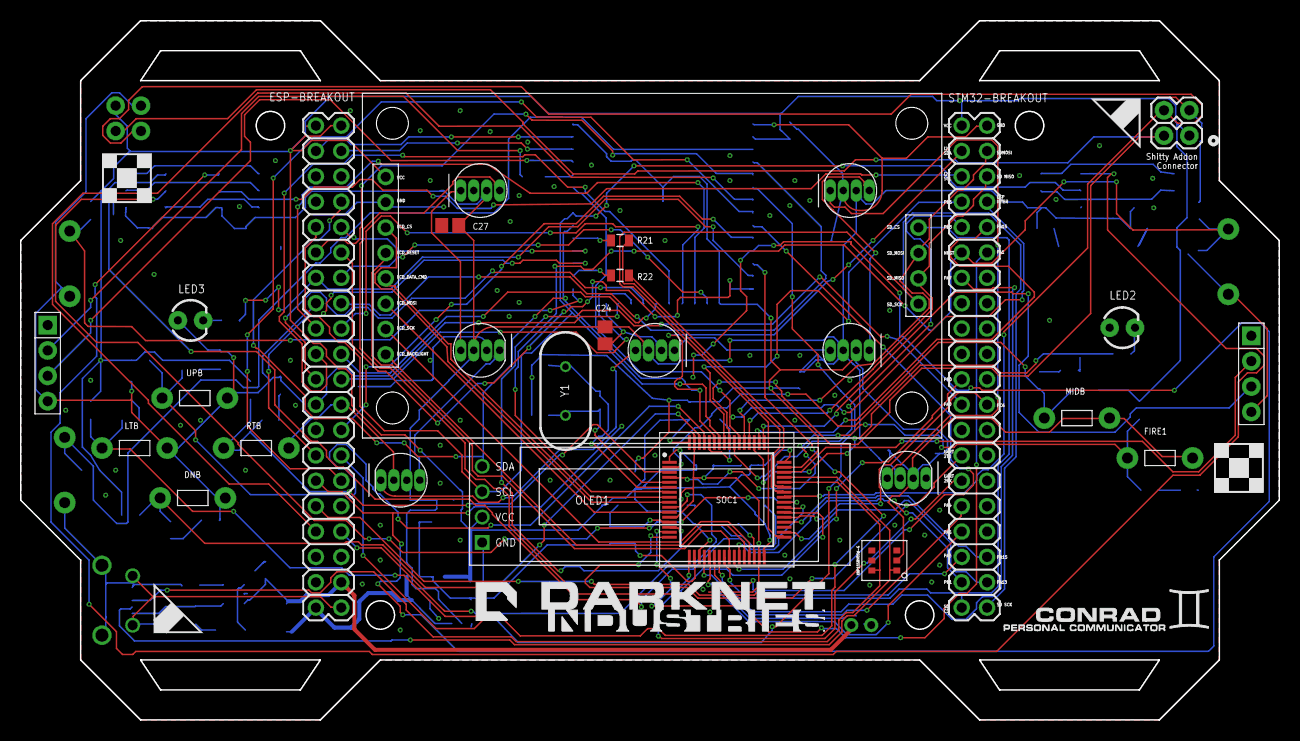
[picture p29: board dc26.brd from above]

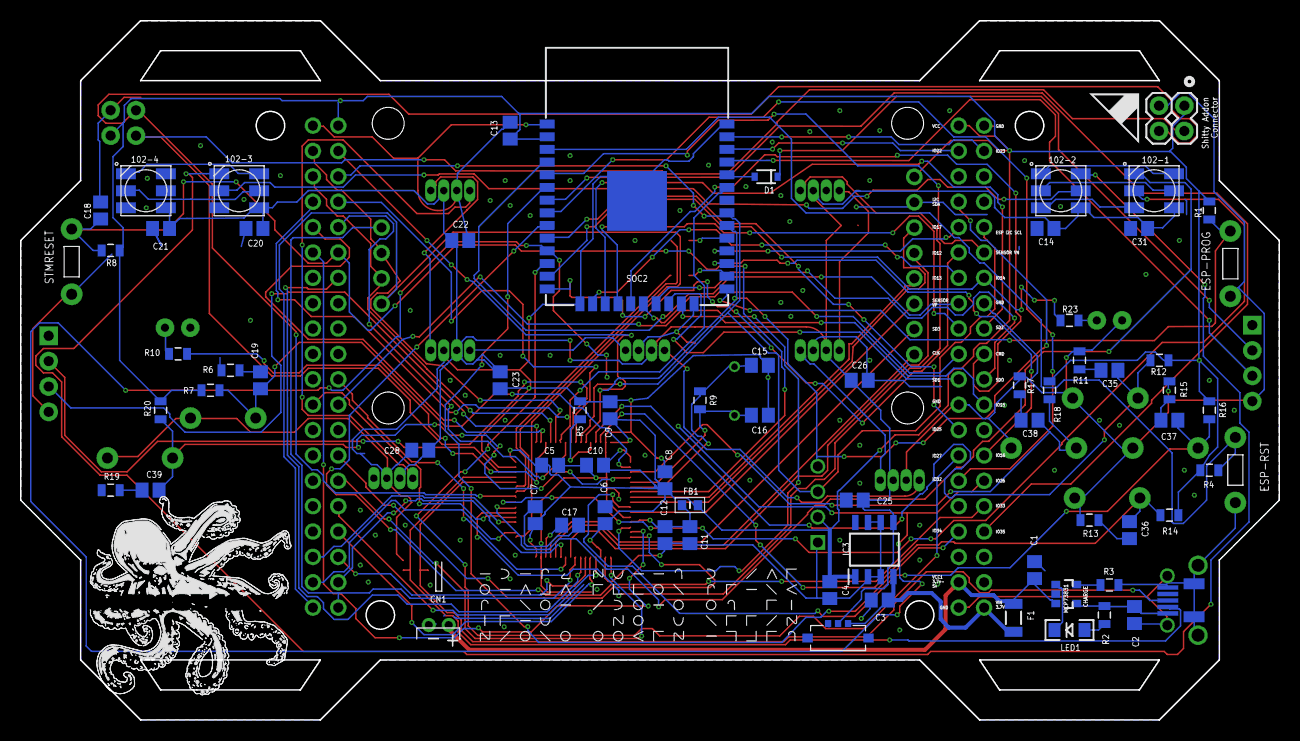
[picture p30: board dc26.brd from below]

Board: 2 copper layers, 126.0 x 70.0 mm, 111 parts (76 on the bottom side), 112 nets.
