thedarknet/dc26-badge/hardware/devboard/dc26-dev-board/dc26-dev-board-apa102c-3.brd

## EAGLE design hardware/devboard/dc26-dev-board/dc26-dev-board-apa102c-3.brd (2018-03-26)

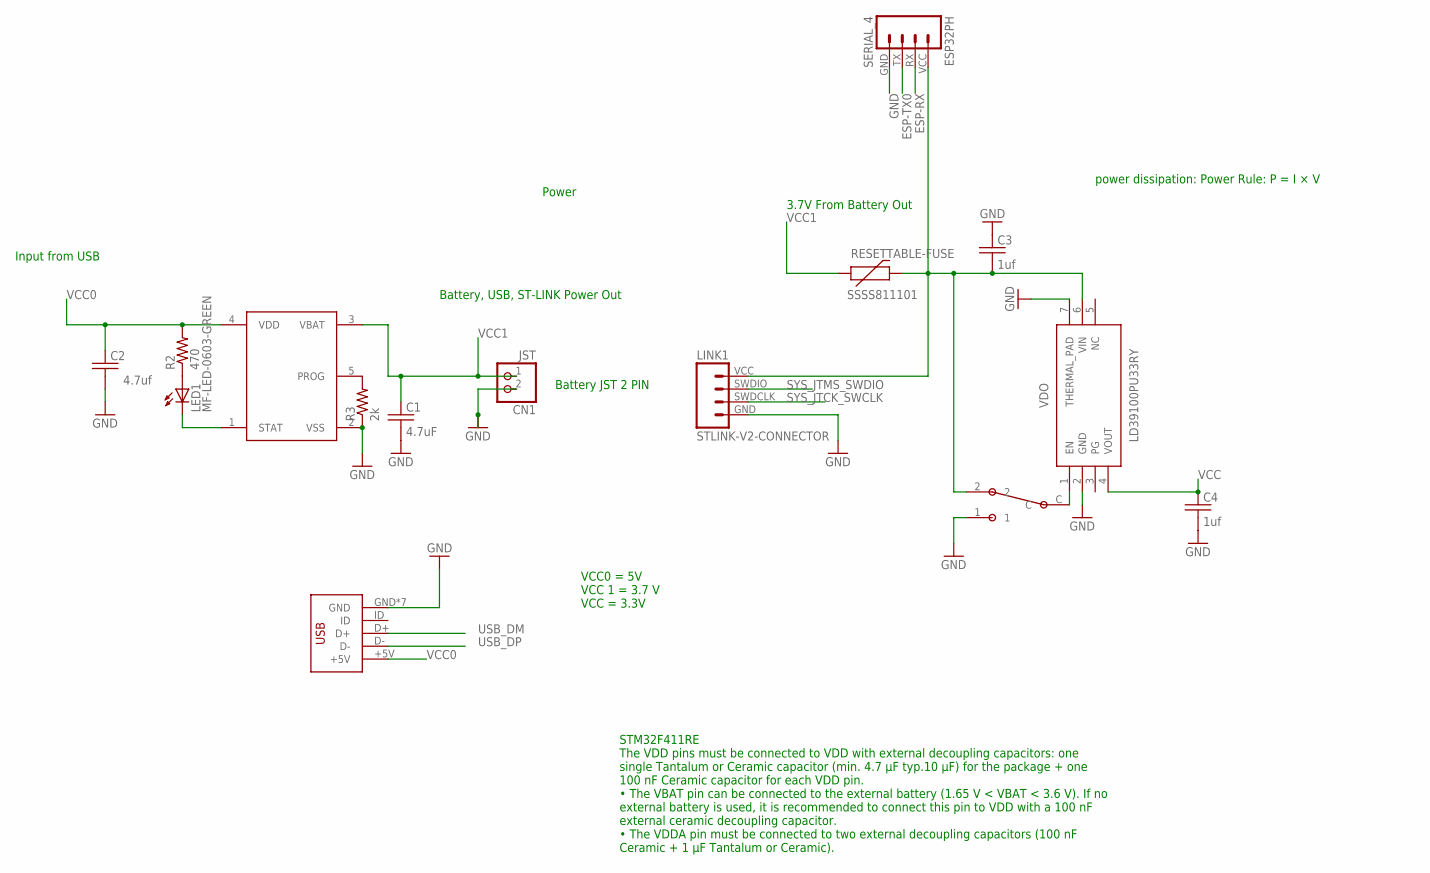
[picture p31: schematic dc26-dev-board-apa102c-3.sch, sheet 1]

Parts:
C1: 4.7uF; C0805
C2: 4.7uf; C0805
C3, C4: 1uf; C0805
CHARGING_CIRCUT: MCP73831; SOT23-5
CN1: JST; JST-PH-2-THM-RA
ESP32PH: SERIAL_4; SERIAL_HEADER_4
LED1: MF-LED-0603-GREEN; LED-1206
LINK1: STLINK-V2-CONNECTOR; 1X04
P1: SSSS811101; SPDT_SSAJ120100
R2: 470; 0805
R3: 2k; 0805
RESETTABLE-FUSE: SSSS811101; PTC-1206
USB: DX4R005JJ2DX4R005JJ2; DX4R005JJ2
VDO: LD39100PU33RY; SON95P300X300X90-7N

Connections:
ESP-RX: ESP32PH.RX; also elsewhere on the board
ESP-TX0: ESP32PH.TX; also elsewhere on the board
GND: C1.2, C2.2, C3.1, C4.2, CHARGING_CIRCUT.2 (VSS), CN1.2 (1), ESP32PH.GND, LINK1.GND, P1.1, R3.1, USB.GND, USB.P$6 (GND), USB.P$7 (GND), USB.P$8 (GND), USB.P$9 (GND), USB.P$10 (GND), USB.P$11 (GND), VDO.2 (GND), VDO.7 (THERMAL_PAD); also elsewhere on the board
unnamed: LED1.A, R2.1
unnamed: CHARGING_CIRCUT.5 (PROG), R3.2
unnamed: CHARGING_CIRCUT.1 (STAT), LED1.C
SYS_JTCK_SWCLK: LINK1.SWDCLK; also elsewhere on the board
SYS_JTMS_SWDIO: LINK1.SWDIO; also elsewhere on the board
USB_DM: USB.D+; also elsewhere on the board
USB_DP: USB.D-; also elsewhere on the board
VCC: C4.1, VDO.4 (VOUT); also elsewhere on the board
VCC0: C2.1, CHARGING_CIRCUT.4 (VDD), R2.2, USB.+5V
VCC1: C1.1, CHARGING_CIRCUT.3 (VBAT), CN1.1 (2), RESETTABLE-FUSE.1
VIN: C3.2, ESP32PH.VCC, LINK1.VCC, P1.2, RESETTABLE-FUSE.2, VDO.6 (VIN); also elsewhere on the board
VIN-EN: P1.C, VDO.1 (EN)

Notes on the sheet:
Input from USB
Battery JST 2 PIN
Battery, USB, ST-LINK Power Out
power dissipation: Power Rule: P = I × V
3.7V From Battery Out
VCC0 = 5V VCC 1 = 3.7 V VCC = 3.3V
Power
STM32F411RE The VDD pins must be connected to VDD with external decoupling capacitors: one single Tantalum or Ceramic capacitor (min. 4.7 μF typ.10 μF) for the package + one 100 nF Ceramic capacitor for each VDD pin. • The VBAT pin can be connected to the external battery (1.65 V < VBAT < 3.6 V). I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
