thedarknet/dc26-badge/hardware/devboard/dc26-dev-board/dc26-dev-board-apa102c-3.brd

## EAGLE design hardware/devboard/dc26-dev-board/dc26-dev-board-apa102c-3.brd (continued)

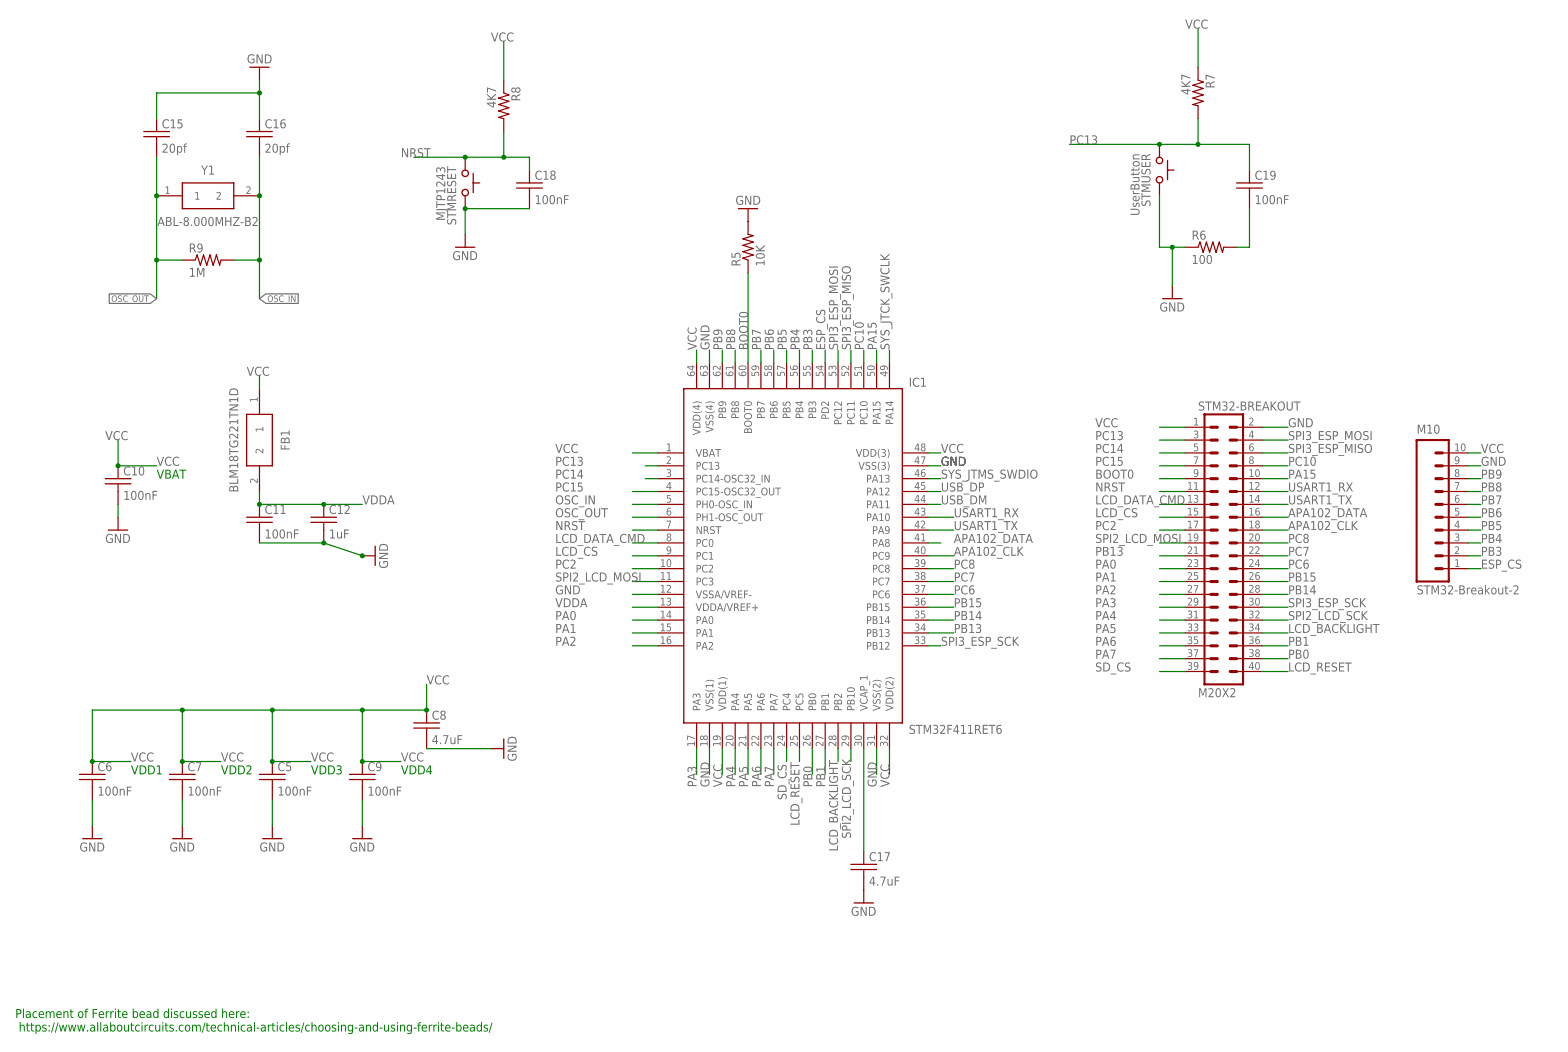
[picture p32: schematic dc26-dev-board-apa102c-3.sch, sheet 2]

Parts:
C5, C6, C7, C9, C10, C11, C18, C19: 100nF; C0805
C8, C17: 4.7uF; C0805
C12: 1uF; C0805
C15, C16: 20pf; C0805
FB1: BLM18TG221TN1D; BEADC1608X75N
IC1: STM32F411RET6; QFP50P1200X1200X160-64N
M10: STM32-Breakout-2; 1X10
R5: 10K; 0805
R6: 100; 0805
R7, R8: 4K7; 0805
R9: 1M; 0805
STM32-BREAKOUT: M20X2; 2X20
STMRESET: MJTP1243; TACTILE-2PIN-NARROW
STMUSER: UserButton; TACTILE-2PIN-NARROW
Y1: ABL-8.000MHZ-B2; HC/49US_(AT49)PTH

Connections:
APA102_CLK: IC1.40 (PC9), STM32-BREAKOUT.18; also elsewhere on the board
APA102_DATA: IC1.41 (PA8), STM32-BREAKOUT.16; also elsewhere on the board
BOOT0: IC1.60 (BOOT0), R5.1, STM32-BREAKOUT.9
ESP_CS: IC1.54 (PD2), M10.1; also elsewhere on the board
GND: C5.2, C6.2, C7.2, C8.2, C9.2, C10.2, C11.2, C12.2, C15.1, C16.1, C17.2, C18.2, IC1.12 (VSSA/VREF-), IC1.18 (VSS(1)), IC1.31 (VSS(2)), IC1.47 (VSS(3)), IC1.63 (VSS(4)), M10.9, R5.2, R6.1, STM32-BREAKOUT.2, STMRESET.P$1 (A), STMUSER.P$1 (A); also elsewhere on the board
LCD_BACKLIGHT: IC1.28 (PB2), STM32-BREAKOUT.34; also elsewhere on the board
LCD_CS: IC1.9 (PC1), STM32-BREAKOUT.15; also elsewhere on the board
LCD_DATA_CMD: IC1.8 (PC0), STM32-BREAKOUT.13; also elsewhere on the board
LCD_RESET: IC1.25 (PC5), STM32-BREAKOUT.40; also elsewhere on the board
unnamed: C19.2, R6.2
unnamed: C17.1, IC1.30 (VCAP_1)
NRST: C18.1, IC1.7 (NRST), R8.2, STM32-BREAKOUT.11, STMRESET.P$2 (C)
OSC_IN: C16.2, IC1.5 (PH0-OSC_IN), R9.2, Y1.2
OSC_OUT: C15.2, IC1.6 (PH1-OSC_OUT), R9.1, Y1.1
PA0: IC1.14 (PA0), STM32-BREAKOUT.23
PA1: IC1.15 (PA1), STM32-BREAKOUT.25
PA2: IC1.16 (PA2), STM32-BREAKOUT.27
PA3: IC1.17 (PA3), STM32-BREAKOUT.29
PA4: IC1.20 (PA4), STM32-BREAKOUT.31
PA5: IC1.21 (PA5), STM32-BREAKOUT.33
PA6: IC1.22 (PA6), STM32-BREAKOUT.35
PA7: IC1.23 (PA7), STM32-BREAKOUT.37
PA15: IC1.50 (PA15), STM32-BREAKOUT.10
PB0: IC1.26 (PB0), STM32-BREAKOUT.38
PB1: IC1.27 (PB1), STM32-BREAKOUT.36
PB3: IC1.55 (PB3), M10.2
PB4: IC1.56 (PB4), M10.3
PB5: IC1.57 (PB5), M10.4
PB6: IC1.58 (PB6), M10.5
PB7: IC1.59 (PB7), M10.6
PB8: IC1.61 (PB8), M10.7
PB9: IC1.62 (PB9), M10.8
PB13: IC1.34 (PB13), STM32-BREAKOUT.21
PB14: IC1.35 (PB14), STM32-BREAKOUT.28
PB15: IC1.36 (PB15), STM32-BREAKOUT.26
PC2: IC1.10 (PC2), STM32-BREAKOUT.17
PC6: IC1.37 (PC6), STM32-BREAKOUT.24
PC7: IC1.38 (PC7), STM32-BREAKOUT.22
PC8: IC1.39 (PC8), STM32-BREAKOUT.20
PC10: IC1.51 (PC10), STM32-BREAKOUT.8
PC13: C19.1, IC1.2 (PC13), R7.2, STM32-BREAKOUT.3, STMUSER.P$2 (C)
PC14: IC1.3 (PC14-OSC32_IN), STM32-BREAKOUT.5
PC15: IC1.4 (PC15-OSC32_OUT), STM32-BREAKOUT.7
SD_CS: IC1.24 (PC4), STM32-BREAKOUT.39; also elsewhere on the board
SPI2_LCD_MOSI: IC1.11 (PC3), STM32-BREAKOUT.19; also elsewhere on the board
SPI2_LCD_SCK: IC1.29 (PB10), STM32-BREAKOUT.32; also elsewhere on the board
SPI3_ESP_MISO: IC1.52 (PC11), STM32-BREAKOUT.6; also elsewhere on the board
SPI3_ESP_MOSI: IC1.53 (PC12), STM32-BREAKOUT.4; also elsewhere on the board
SPI3_ESP_SCK: IC1.33 (PB12), STM32-BREAKOUT.30; also elsewhere on the board
SYS_JTCK_SWCLK: IC1.49 (PA14); also elsewhere on the board
SYS_JTMS_SWDIO: IC1.46 (PA13); also elsewhere on the board
USART1_RX: IC1.43 (PA10), STM32-BREAKOUT.12
USART1_TX: IC1.42 (PA9), STM32-BREAKOUT.14
USB_DM: IC1.44 (PA11); also elsewhere on the board
USB_DP: IC1.45 (PA12); also elsewhere on the board
VCC: C5.1, C6.1, C7.1, C8.1, C9.1, C10.1, FB1.1, IC1.1 (VBAT), IC1.19 (VDD(1)), IC1.32 (VDD(2)), IC1.48 (VDD(3)), IC1.64 (VDD(4)), M10.10, R7.1, R8.1, STM32-BREAKOUT.1; also elsewhere on the board
VDDA: C11.1, C12.1, FB1.2, IC1.13 (VDDA/VREF+)

Notes on the sheet:
Placement of Ferrite bead discussed here: https://www.allaboutcircuits.com/technical-articles/choosing-and-using-ferrite-beads/
VBAT
VDD1
VDD2
VDD3
VDD4

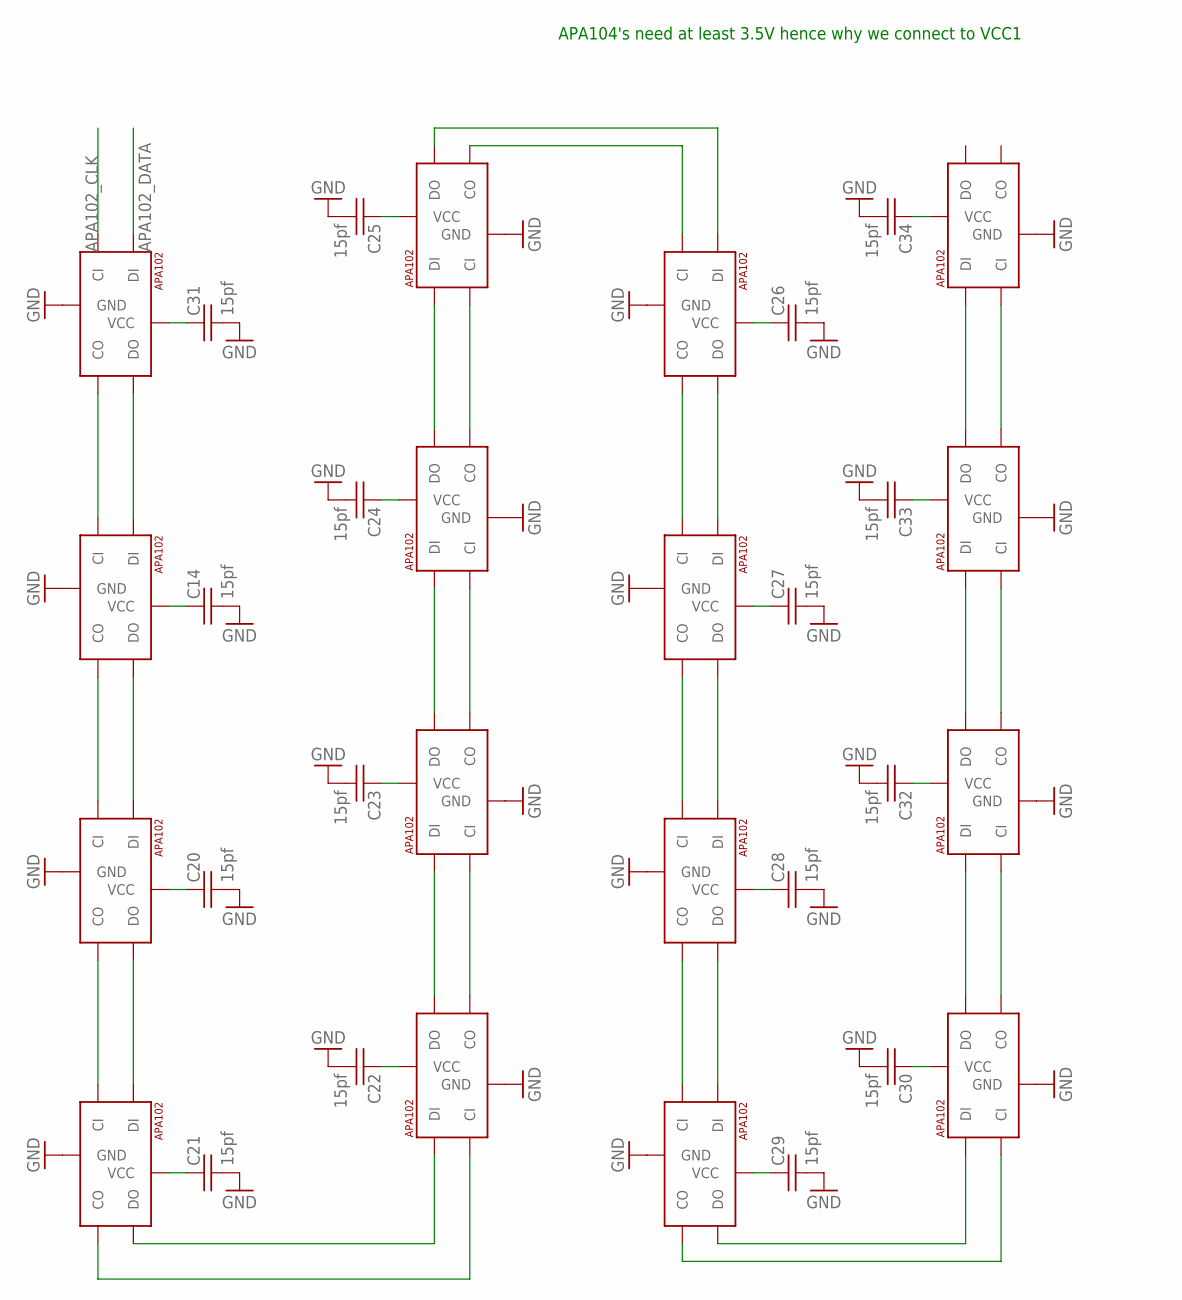
[picture p33: schematic dc26-dev-board-apa102c-3.sch, sheet 3]

Parts:
C14, C20, C21, C22, C23, C24, C25, C26, C27, C28, C29, C30, C31, C32, C33, C34: 15pf; C0805
U$5, U$6, U$7, U$8, U$9, U$10, U$11, U$12, U$13, U$14, U$15, U$16, U$17, U$18, U$19, U$20: APA1025050; APA102_5050

Connections:
APA102_CLK: U$8.5 (CI); also elsewhere on the board
APA102_DATA: U$8.4 (DI); also elsewhere on the board
GND: C14.2, C20.2, C21.2, C22.2, C23.2, C24.2, C25.2, C26.2, C27.2, C28.2, C29.2, C30.2, C31.2, C32.2, C33.2, C34.2, U$5.6 (GND), U$6.6 (GND), U$7.6 (GND), U$8.6 (GND), U$9.6 (GND), U$10.6 (GND), U$11.6 (GND), U$12.6 (GND), U$13.6 (GND), U$14.6 (GND), U$15.6 (GND), U$16.6 (GND), U$17.6 (GND), U$18.6 (GND), U$19.6 (GND), U$20.6 (GND); also elsewhere on the board
unnamed: U$5.5 (CI), U$8.2 (CO)
unnamed: U$5.2 (CO), U$6.5 (CI)
unnamed: U$6.2 (CO), U$7.5 (CI)
unnamed: U$6.3 (DO), U$7.4 (DI)
unnamed: U$5.3 (DO), U$6.4 (DI)
unnamed: U$5.4 (DI), U$8.3 (DO)
unnamed: U$7.3 (DO), U$9.4 (DI)
unnamed: U$7.2 (CO), U$9.5 (CI)
unnamed: U$9.2 (CO), U$10.5 (CI)
unnamed: U$9.3 (DO), U$10.4 (DI)
unnamed: U$10.2 (CO), U$11.5 (CI)
unnamed: U$10.3 (DO), U$11.4 (DI)
unnamed: U$11.2 (CO), U$12.5 (CI)
unnamed: U$11.3 (DO), U$12.4 (DI)
unnamed: U$12.2 (CO), U$13.5 (CI)
unnamed: U$12.3 (DO), U$13.4 (DI)
unnamed: U$13.2 (CO), U$14.5 (CI)
unnamed: U$13.3 (DO), U$14.4 (DI)
unnamed: U$14.2 (CO), U$15.5 (CI)
unnamed: U$14.3 (DO), U$15.4 (DI)
unnamed: U$15.2 (CO), U$16.5 (CI)
unnamed: U$15.3 (DO), U$16.4 (DI)
unnamed: U$16.3 (DO), U$17.4 (DI)
unnamed: U$16.2 (CO), U$17.5 (CI)
unnamed: U$17.3 (DO), U$18.4 (DI)
unnamed: U$17.2 (CO), U$18.5 (CI)
unnamed: U$18.2 (CO), U$19.5 (CI)
unnamed: U$18.3 (DO), U$19.4 (DI)
unnamed: U$19.2 (CO), U$20.5 (CI)
unnamed: U$19.3 (DO), U$20.4 (DI)
VIN: C14.1, C20.1, C21.1, C22.1, C23.1, C24.1, C25.1, C26.1, C27.1, C28.1, C29.1, C30.1, C31.1, C32.1, C33.1, C34.1, U$5.1 (VCC), U$6.1 (VCC), U$7.1 (VCC), U$8.1 (VCC), U$9.1 (VCC), U$10.1 (VCC), U$11.1 (VCC), U$12.1 (VCC), U$13.1 (VCC), U$14.1 (VCC), U$15.1 (VCC), U$16.1 (VCC), U$17.1 (VCC), U$18.1 (VCC), U$19.1 (VCC), U$20.1 (VCC); also elsewhere on the board

Notes on the sheet:
APA104's need at least 3.5V hence why we connect to VCC1

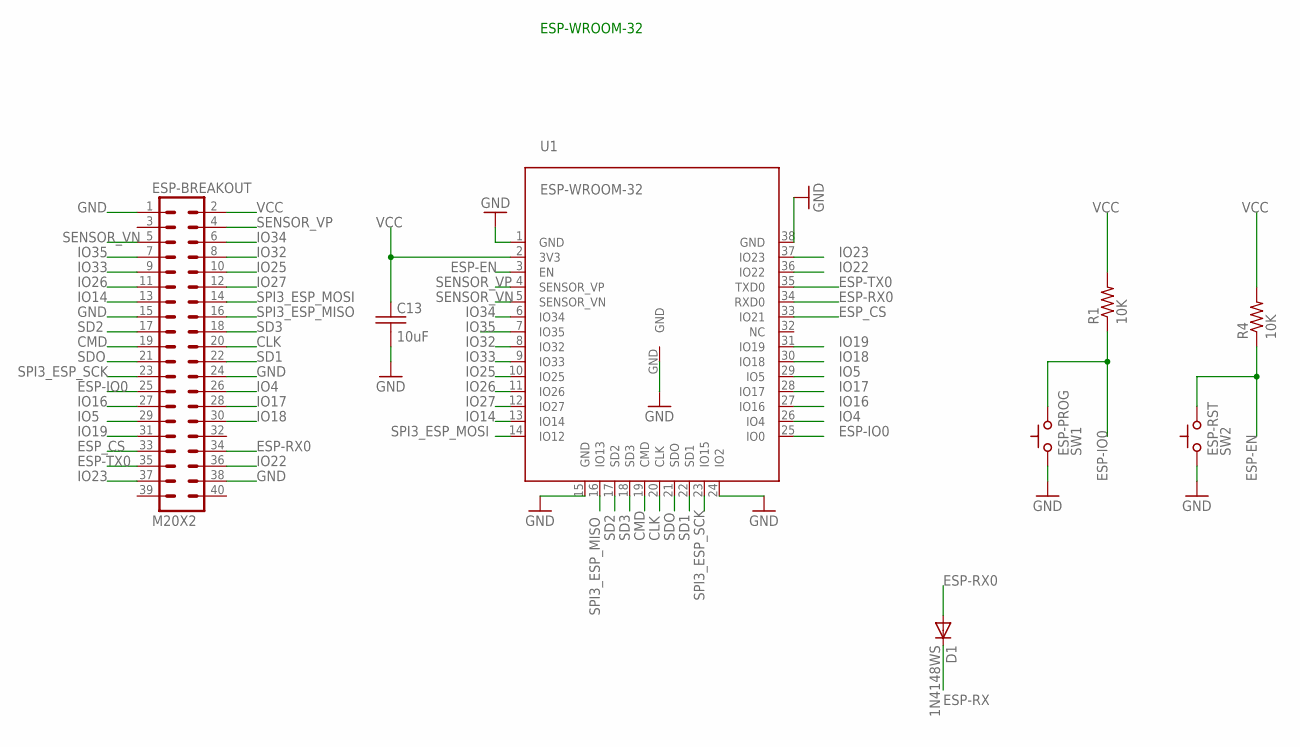
[picture p34: schematic dc26-dev-board-apa102c-3.sch, sheet 4]

Parts:
C13: 10uF; C0805
D1: 1N4148WS; SOD-323
ESP-BREAKOUT: M20X2; 2X20
ESP-PROG: SW1; TACTILE-2PIN-NARROW
ESP-RST: SW2; TACTILE-2PIN-NARROW
R1, R4: 10K; 0805
U1: ESP-WROOM-32

Connections:
CLK: ESP-BREAKOUT.20, U1.20 (CLK)
CMD: ESP-BREAKOUT.19, U1.19 (CMD)
ESP-EN: ESP-RST.P$1 (A), R4.1, U1.3 (EN)
ESP-IO0: ESP-BREAKOUT.25, ESP-PROG.P$1 (A), R1.1, U1.25 (IO0)
ESP-RX: D1.1 (C); also elsewhere on the board
ESP-RX0: D1.2 (A), ESP-BREAKOUT.34, U1.34 (RXD0)
ESP-TX0: ESP-BREAKOUT.35, U1.35 (TXD0); also elsewhere on the board
ESP_CS: ESP-BREAKOUT.33, U1.33 (IO21); also elsewhere on the board
GND: C13.2, ESP-BREAKOUT.1, ESP-BREAKOUT.15, ESP-BREAKOUT.24, ESP-BREAKOUT.38, ESP-PROG.P$2 (C), ESP-RST.P$2 (C), U1.1 (GND), U1.15 (GND), U1.24 (IO2), U1.38 (GND), U1.GND; also elsewhere on the board
IO4: ESP-BREAKOUT.26, U1.26 (IO4)
IO5: ESP-BREAKOUT.29, U1.29 (IO5)
IO14: ESP-BREAKOUT.13, U1.13 (IO14)
IO16: ESP-BREAKOUT.27, U1.27 (IO16)
IO17: ESP-BREAKOUT.28, U1.28 (IO17)
IO18: ESP-BREAKOUT.30, U1.30 (IO18)
IO19: ESP-BREAKOUT.31, U1.31 (IO19)
IO22: ESP-BREAKOUT.36, U1.36 (IO22)
IO23: ESP-BREAKOUT.37, U1.37 (IO23)
IO25: ESP-BREAKOUT.10, U1.10 (IO25)
IO26: ESP-BREAKOUT.11, U1.11 (IO26)
IO27: ESP-BREAKOUT.12, U1.12 (IO27)
IO32: ESP-BREAKOUT.8, U1.8 (IO32)
IO33: ESP-BREAKOUT.9, U1.9 (IO33)
IO34: ESP-BREAKOUT.6, U1.6 (IO34)
IO35: ESP-BREAKOUT.7, U1.7 (IO35)
SD1: ESP-BREAKOUT.22, U1.22 (SD1)
SD2: ESP-BREAKOUT.17, U1.17 (SD2)
SD3: ESP-BREAKOUT.18, U1.18 (SD3)
SDO: ESP-BREAKOUT.21, U1.21 (SDO)
SENSOR_VN: ESP-BREAKOUT.5, U1.5 (SENSOR_VN)
SENSOR_VP: ESP-BREAKOUT.4, U1.4 (SENSOR_VP)
SPI3_ESP_MISO: ESP-BREAKOUT.16, U1.16 (IO13); also elsewhere on the board
SPI3_ESP_MOSI: ESP-BREAKOUT.14, U1.14 (IO12); also elsewhere on the board
SPI3_ESP_SCK: ESP-BREAKOUT.23, U1.23 (IO15); also elsewhere on the board
VCC: C13.1, ESP-BREAKOUT.2, R1.2, R4.2, U1.2 (3V3); also elsewhere on the board

Notes on the sheet:
ESP-WROOM-32

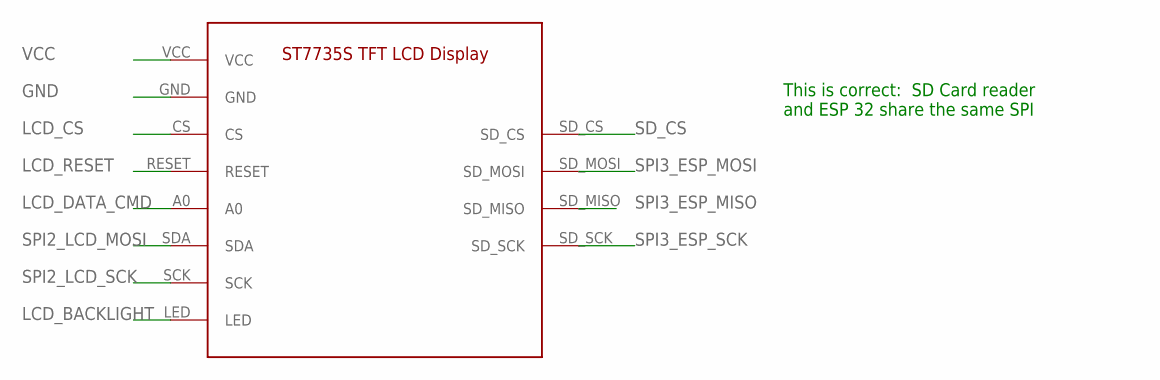
[picture p35: schematic dc26-dev-board-apa102c-3.sch, sheet 5]

Parts:
U$1: ST7735S_LCD_MODULE; ST7735S_LCD_DISPLAY

Connections:
GND: U$1.GND; also elsewhere on the board
LCD_BACKLIGHT: U$1.LED; also elsewhere on the board
LCD_CS: U$1.CS; also elsewhere on the board
LCD_DATA_CMD: U$1.A0; also elsewhere on the board
LCD_RESET: U$1.RESET; also elsewhere on the board
SD_CS: U$1.SD_CS; also elsewhere on the board
SPI2_LCD_MOSI: U$1.SDA; also elsewhere on the board
SPI2_LCD_SCK: U$1.SCK; also elsewhere on the board
SPI3_ESP_MISO: U$1.SD_MISO; also elsewhere on the board
SPI3_ESP_MOSI: U$1.SD_MOSI; also elsewhere on the board
SPI3_ESP_SCK: U$1.SD_SCK; also elsewhere on the board
VCC: U$1.VCC; also elsewhere on the board

Notes on the sheet:
This is correct: SD Card reader and ESP 32 share the same SPI

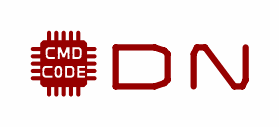
[picture p36: schematic dc26-dev-board-apa102c-3.sch, sheet 6]

Parts:
U$2: CMD_C0DE_LOGO
U$3: DARKNET_DD; DARKNET_D
U$4: DARKNET_NN; DARKNET_N

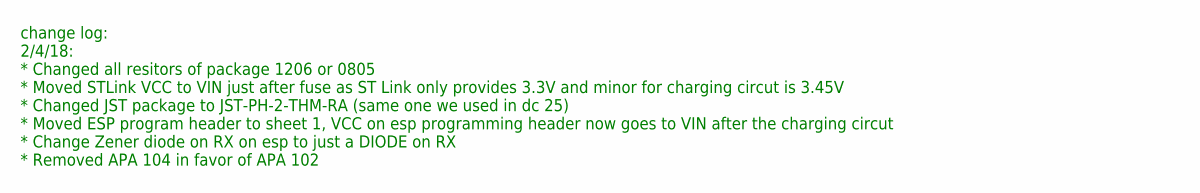
[picture p37: schematic dc26-dev-board-apa102c-3.sch, sheet 7]

Notes on the sheet:
change log: 2/4/18: * Changed all resitors of package 1206 or 0805 * Moved STLink VCC to VIN just after fuse as ST Link only provides 3.3V and minor for charging circut is 3.45V * Changed JST package to JST-PH-2-THM-RA (same one we used in dc 25) * Moved ESP program header to sheet 1, VCC on esp pr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

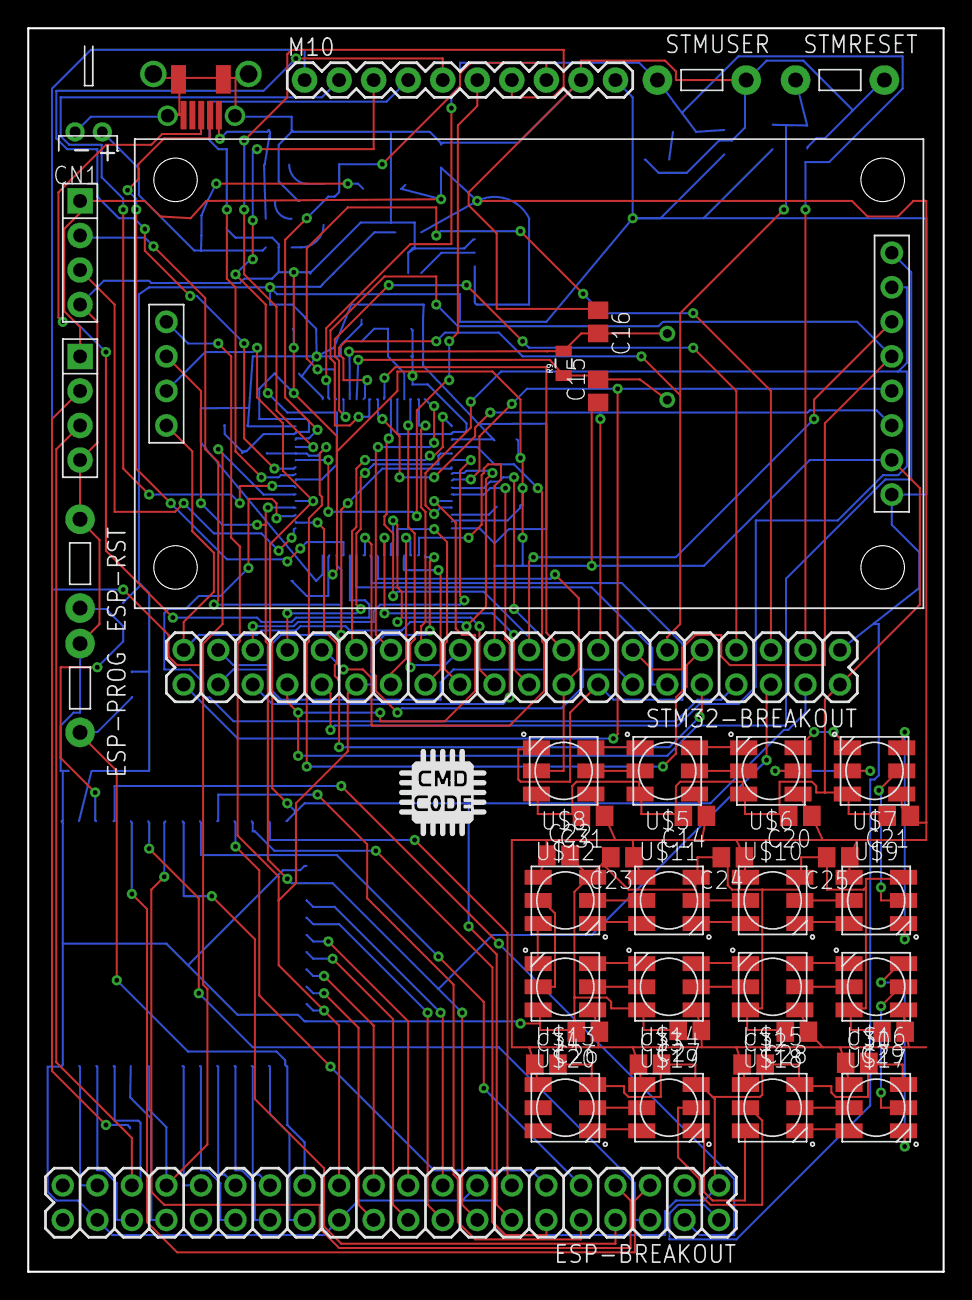
[picture p38: board dc26-dev-board-apa102c-3.brd from above]

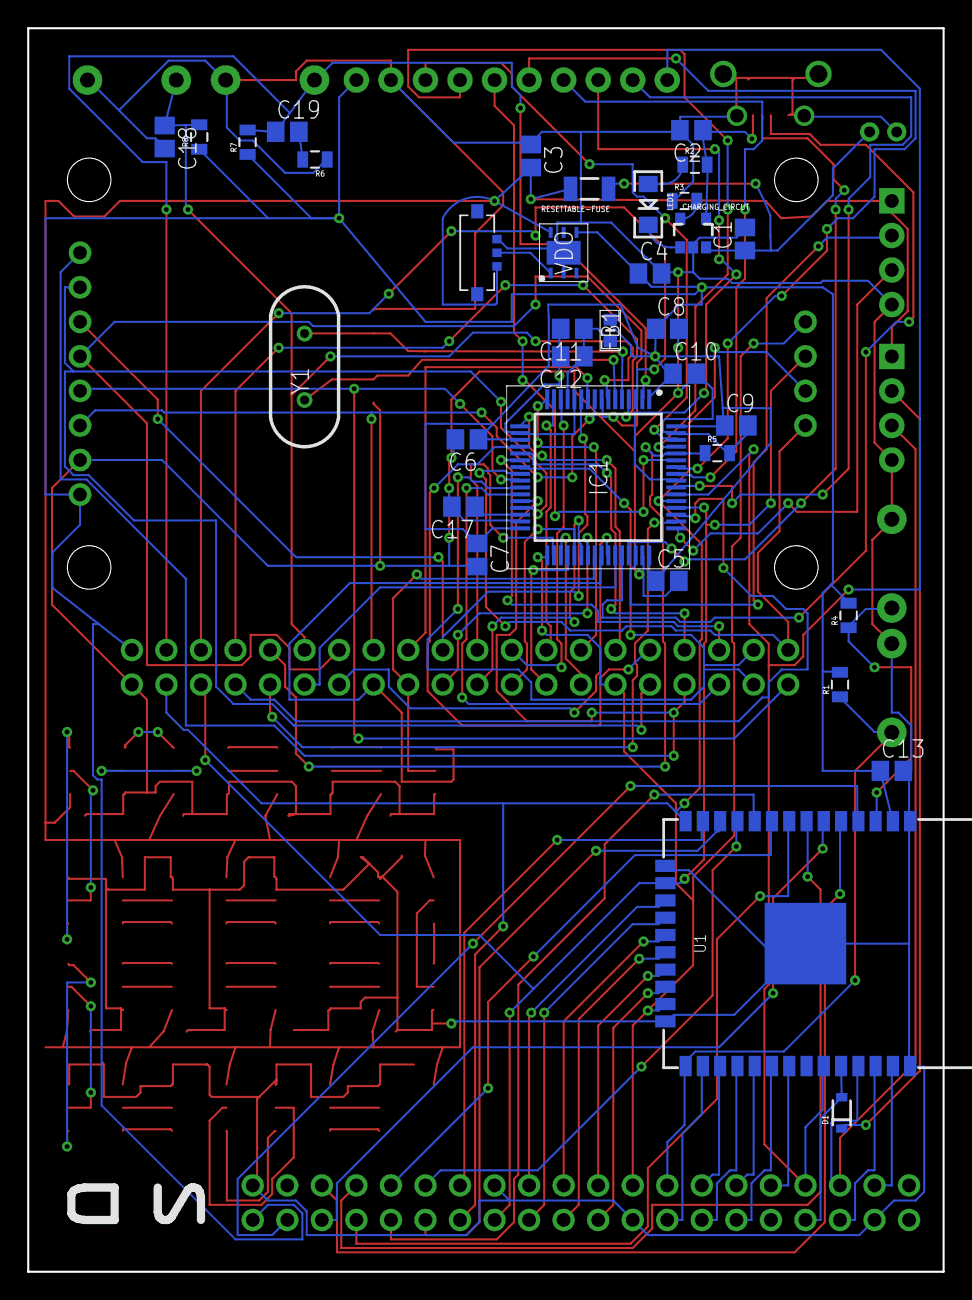
[picture p39: board dc26-dev-board-apa102c-3.brd from below]

Board: 2 copper layers, 67.3 x 91.4 mm, 84 parts (34 on the bottom side), 123 nets.
