thedarknet/dc26-badge/firmware/DevBoard/darknet-7/Inc/main.h

#define MID_BUTTON1_Pin GPIO_PIN_13
#define MID_BUTTON1_GPIO_Port GPIOC
#define BUTTON_RIGHT_Pin GPIO_PIN_14
#define BUTTON_RIGHT_GPIO_Port GPIOC
#define BUTTON_FIRE1_Pin GPIO_PIN_15
#define BUTTON_FIRE1_GPIO_Port GPIOC
#define LCD_DATA_CMD_Pin GPIO_PIN_0
#define LCD_DATA_CMD_GPIO_Port GPIOC
#define LCD_CS_Pin GPIO_PIN_1
#define LCD_CS_GPIO_Port GPIOC
#define BUTTON_LEFT_Pin GPIO_PIN_2
#define BUTTON_LEFT_GPIO_Port GPIOC
#define SPI2_LCD_MOSI_Pin GPIO_PIN_3
#define SPI2_LCD_MOSI_GPIO_Port GPIOC
#define SD_CS_Pin GPIO_PIN_4
#define SD_CS_GPIO_Port GPIOC
#define LCD_RESET_Pin GPIO_PIN_5
#define LCD_RESET_GPIO_Port GPIOC
#define LCD_BACKLIGHT_Pin GPIO_PIN_2
#define LCD_BACKLIGHT_GPIO_Port GPIOB
#define SPI2_LCD_SCK_Pin GPIO_PIN_10
#define SPI2_LCD_SCK_GPIO_Port GPIOB
#define SPI3_SD_SCK_Pin GPIO_PIN_12
#define SPI3_SD_SCK_GPIO_Port GPIOB
#define GPIO_APA106_DATA_Pin GPIO_PIN_7
#define GPIO_APA106_DATA_GPIO_Port GPIOC
#define GPIO_APA102_DATA_Pin GPIO_PIN_8
#define GPIO_APA102_DATA_GPIO_Port GPIOC
#define TIM_APA102_CLK_Pin GPIO_PIN_9
#define TIM_APA102_CLK_GPIO_Port GPIOC
#define SHITTY_ADD_ON_BADGE_I2C_SCL_Pin GPIO_PIN_8
#define SHITTY_ADD_ON_BADGE_I2C_SCL_GPIO_Port GPIOA
#define USART1_TX_TO_ESP_RX_PIN_5_Pin GPIO_PIN_9
#define USART1_TX_TO_ESP_RX_PIN_5_GPIO_Port GPIOA
#define USART1_RX_TO_ESP_TX_PIN_4_Pin GPIO_PIN_10
#define USART1_RX_TO_ESP_TX_PIN_4_GPIO_Port GPIOA
#define SIMPLE_LED1_Pin GPIO_PIN_10
#define SIMPLE_LED1_GPIO_Port GPIOC
#define SPI3_SD_MISO_Pin GPIO_PIN_11
#define SPI3_SD_MISO_GPIO_Port GPIOC
#define SPI3_SD_MOSI_Pin GPIO_PIN_12
#define SPI3_SD_MOSI_GPIO_Port GPIOC
#define ESP_INTER_Pin GPIO_PIN_2
#define ESP_INTER_GPIO_Port GPIOD
#define ESP_INTER_EXTI_IRQn EXTI2_IRQn
#define SHITTY_ADD_ON_BADGE_I2C_SDA_Pin GPIO_PIN_4
#define SHITTY_ADD_ON_BADGE_I2C_SDA_GPIO_Port GPIOB
#define ESP_I2C1_SCL_Pin GPIO_PIN_6
#define ESP_I2C1_SCL_GPIO_Port GPIOB
#define ESP_I2C1_SDA_Pin GPIO_PIN_7
#define ESP_I2C1_SDA_GPIO_Port GPIOB
#define BUTTON_UP_Pin GPIO_PIN_8
#define BUTTON_UP_GPIO_Port GPIOB
#define BUTTON_DOWN_Pin GPIO_PIN_9
#define BUTTON_DOWN_GPIO_Port GPIOB
