thedarknet/dc26-badge/firmware/DevBoard/darknet-7/Src/darknet/menus/pairing_state.h

#ifndef IRMENU_H_
#define IRMENU_H_

#include "darknet7_base_state.h"
#include "../mcu_to_mcu.h"
#include "../KeyStore.h"

namespace darknet7 {
	class ESPToSTM;
}

class PairingState: public Darknet7BaseState {
public:
	struct AliceInitConvo {
		uint8_t irmsgid;
		uint8_t AlicePublicKey[ContactStore::PUBLIC_KEY_COMPRESSED_LENGTH];
		uint16_t AliceRadioID;
		char AliceName[ContactStore::AGENT_NAME_LENGTH];
	};

	struct BobReplyToInit {
		uint8_t irmsgid;
		uint8_t BoBPublicKey[ContactStore::PUBLIC_KEY_COMPRESSED_LENGTH];
		uint16_t BoBRadioID;
		char BobAgentName[ContactStore::AGENT_NAME_LENGTH];
		uint8_t SignatureOfAliceData[ContactStore::SIGNATURE_LENGTH];
	};

	struct AliceToBobSignature {
		uint8_t irmsgid;
		uint8_t signature[48];
	};
public:
	PairingState();
	virtual ~PairingState();
	void receiveSignal(MCUToMCU*,const MSGEvent<darknet7::BadgesInArea>* mevt);
	void receiveSignal(MCUToMCU*,const MSGEvent<darknet7::BLESecurityConfirm>* mevt);
	void receiveSignal(MCUToMCU*,const MSGEvent<darknet7::BLEConnected>* mevt);
	void receiveSignal(MCUToMCU*,const MSGEvent<darknet7::BLEMessageFromDevice>* mevt);
	void receiveSignal(MCUToMCU*,const MSGEvent<darknet7::BLEPairingComplete>* mevt);
protected:
	enum INTERNAL_STATE { NONE, FETCHING_DATA, DISPLAY_DATA,
							INITIATING_CONNECTION, CONNECTING, CONFIRMING,
							ALICE_SEND_ONE, ALICE_SEND_TWO,
							BOB_SEND_ONE, BOB_SEND_TWO,
							RECEIVE_DATA,
							PAIRING_SUCCESS, PAIRING_COMPLETE, PAIRING_FAILED };
	virtual cmdc0de::ErrorType onInit();
	virtual cmdc0de::StateBase::ReturnStateContext onRun();
	virtual cmdc0de::ErrorType onShutdown();
	void CleanUp();
private:
	// Badge:Address list
	cmdc0de::GUIListData BadgeList;
	cmdc0de::GUIListItemData Items[8];
	char ListBuffer[8][12];
	char AddressBuffer[8][18];
	char MesgBuf[200];
	unsigned int MesgLen;

	// Internal State information
	INTERNAL_STATE InternalState;
	uint32_t ESPRequestID;
	uint32_t timesRunCalledSinceReset;

	// Pairing State information
	uint16_t TimeoutMS;
	uint8_t RetryCount;
	uint8_t CurrentRetryCount;
	uint32_t TimeInState;
	AliceInitConvo AIC;
	BobReplyToInit BRTI;
	AliceToBobSignature ATBS;
	unsigned char msgId = 0;
	bool gotBadgeList = false;
	bool securityConfirmed = false;
	bool bleConnected = false;
	bool isAlice = false;
};

#endif
