thedarknet/dc26-badge/firmware/DevBoard/darknet-7/Src/darknet/menus/SendMsgState.cpp

#include "SendMsgState.h"
#include "../darknet7.h"

using cmdc0de::ErrorType;
using cmdc0de::RGBColor;
using cmdc0de::StateBase;

SendMsgState::SendMsgState() :
		Darknet7BaseState(), RadioID(0), AgentName(0), MsgBuffer(), InternalState(TYPE_MESSAGE) {

}
SendMsgState::~SendMsgState() {

}
void SendMsgState::setContactToMessage(const uint16_t radioID, const char *agentName) {
	RadioID = radioID;
	AgentName = agentName;
}

ErrorType SendMsgState::onInit() {

	return ErrorType();
}

StateBase::ReturnStateContext SendMsgState::onRun() {
	StateBase *nextState = this;

	return ReturnStateContext(nextState);
}

ErrorType SendMsgState::onShutdown() {
	if (shouldReset()) {
		RadioID = 0;
		AgentName = 0;
	}
	return ErrorType();
}
