thedarknet/dc26-badge/firmware/DevBoard/darknet-7/Src/darknet/mcu_to_mcu.cpp

/*
 * mcu_to_mcu.cpp
 *
 *  Created on: Jun 22, 2018
 *      Author: cmdc0de
 */

#include <usart.h>
#include "mcu_to_mcu.h"
#include "libstm32/etl/src/crc16.h"
#include "libstm32/logger.h"

MCUToMCU *MCUToMCU::mSelf = 0;
uint8_t UartRXBuffer[MCUToMCU::TOTAL_MESSAGE_SIZE * 2] = { 0 };

const darknet7::ESPToSTM *MCUToMCU::Message::asESPToSTM() {
	return darknet7::GetSizePrefixedESPToSTM(&MessageData[ENVELOP_HEADER]);
}

bool MCUToMCU::Message::verifyESPToSTM() {
	flatbuffers::Verifier v(&MessageData[ENVELOP_HEADER],getDataSize());
	return darknet7::VerifySizePrefixedESPToSTMBuffer(v);
}

//We listen for the for our envelop portion of our message which is: 4 bytes:
// bits 0-10 is the size of the message coming max message size = 1024
// bit 11: reserved
// bit 12: reserved
// bit 13: reserved
// bit 14: reserved
// bit 15: reserved
// bit 16-31: CRC 16 of entire message
//set up for our 4 byte envelop header

MCUToMCU::Message::Message() :
		SizeAndFlags(0), Crc16(0), MessageData() {

}

void MCUToMCU::Message::set(uint16_t sf, uint16_t crc, uint8_t *data) {
	SizeAndFlags = sf;
	Crc16 = crc;
	MessageData[0] = sf & 0xFF;
	MessageData[1] = (sf & 0xFF00) >> 8;
	uint16_t s = MessageData[0];
	//s |= ((uint16_t) MessageData[1]) << 8;
	//assert(s==getDataSize());
	MessageData[2] = Crc16 & 0xFF;
	MessageData[3] = (Crc16 & 0xFF00) >> 8;
	memcpy(&MessageData[ENVELOP_HEADER], data, getDataSize());
}

void MCUToMCU::Message::setFlag(uint16_t flags) {
	SizeAndFlags|=flags;
}

bool MCUToMCU::Message::checkFlags(uint16_t flags) {
	return (SizeAndFlags&flags)==flags;
}

HAL_StatusTypeDef MCUToMCU::Message::transmit(UART_HandleTypeDef *huart) {
	HAL_StatusTypeDef status = HAL_UART_Transmit_IT(huart,&MessageData[0],getMessageSize());
	if(status==HAL_OK) {
		setFlag(MESSAGE_FLAG_TRANSMITTED);
	} else {
		ERRMSG("transmit failed: %d", status);
	}
	return status;
}

void MCUToMCU::resetUART() {
	HAL_UART_DeInit(UartHandler);
	init(UartHandler);
}

void MCUToMCU::init(UART_HandleTypeDef *uart) {
	UartHandler = uart;
	MX_USART1_UART_Init();
	HAL_LIN_Init(UartHandler, UART_LINBREAKDETECTLENGTH_10B);
	HAL_UART_Receive_IT(UartHandler, &UartRXBuffer[0],	MCUToMCU::TOTAL_MESSAGE_SIZE);
}

void HAL_UART_RxCpltCallback(UART_HandleTypeDef *huart) {
	if (huart == MCUToMCU::get().getUART()) {
		MCUToMCU::get().handleMcuToMcu();
	}
}

void HAL_UART_ErrorCallback(UART_HandleTypeDef *huart) {
	if (huart == MCUToMCU::get().getUART()) {
		MCUToMCU::get().onError();
	}
}

void HAL_UART_TxCpltCallback(UART_HandleTypeDef *huart) {
	if (huart == MCUToMCU::get().getUART()) {
		MCUToMCU::get().onTransmitionComplete();
	}
}

void MCUToMCU::onError() {
	MCUToMCU::get().handleMcuToMcu();
}

void MCUToMCU::onTransmitionComplete() {
	Message &m = Outgoing.front();
	if(m.checkFlags(Message::MESSAGE_FLAG_TRANSMITTED)) {
		Outgoing.pop();
		//HAL_LIN_SendBreak(UartHandler);
	}
	transmitNow();
}

MCUToMCU &MCUToMCU::get() {
	if (0 == mSelf) {
		mSelf = new MCUToMCU();
	}
	return *mSelf;
}

MCUToMCU::MCUToMCU() :
		InComing(), Outgoing(), UartHandler(0) {

}

void MCUToMCU::handleMcuToMcu() {
	uint16_t size = UartHandler->RxXferSize-UartHandler->RxXferCount;
	//we have received something and we have also gotten a line break
	if (size > ENVELOP_HEADER && __HAL_UART_GET_FLAG(UartHandler, UART_FLAG_LBD)) {
		uint16_t firstTwo = (*((uint16_t *) &UartRXBuffer[0]));
		uint16_t dataSize = firstTwo & 0x7FF; //0-10 bits are size
		uint16_t crcFromESP = (*((uint16_t *) &UartRXBuffer[2]));
		if(dataSize<=size) {
			etl::crc16 crc(&UartRXBuffer[ENVELOP_HEADER],
					&UartRXBuffer[ENVELOP_HEADER] + dataSize);
			if (crc.value() != crcFromESP) {
				ERRMSG("CRC ERROR in handle MCU To MCU.\n");
			}
			Message &m = InComing.push();
			m.set(firstTwo, crcFromESP, &UartRXBuffer[ENVELOP_HEADER]);
			if(!m.verifyESPToSTM()) {
				ERRMSG("invalid message");
				//invalid message
				InComing.pop();
			}
			HAL_UART_AbortReceive_IT(UartHandler);
			HAL_UART_Receive_IT(UartHandler, &UartRXBuffer[0], MAX_MESSAGE_SIZE);
		} else {
			HAL_UART_Receive_IT(UartHandler, &UartRXBuffer[size], MAX_MESSAGE_SIZE-size);
		}
	} else {
		HAL_UART_Receive_IT(UartHandler, &UartRXBuffer[size], MAX_MESSAGE_SIZE-size);
	}
}

bool MCUToMCU::send(const flatbuffers::FlatBufferBuilder &fbb) {
	uint8_t *msg = fbb.GetBufferPointer();
	uint32_t size = fbb.GetSize();
	assert(size < MAX_MESSAGE_SIZE);
	etl::crc16 crc(msg, msg + size);
	Message &m = Outgoing.push();
	m.set(size, crc.value(), msg);

	return transmitNow();
}

bool MCUToMCU::transmitNow() {
	if ((UartHandler->gState == HAL_UART_STATE_ERROR || UartHandler->gState==HAL_UART_STATE_TIMEOUT)) {
		resetUART();
	}
	if ((UartHandler->gState == HAL_UART_STATE_READY) && !Outgoing.empty()) {
		Message &m = Outgoing.front();
		m.transmit(UartHandler);
	}
	return true;
}

void MCUToMCU::process() {
	if (!InComing.empty()) {
		Message &m = InComing.front();
		const darknet7::ESPToSTM *msg = m.asESPToSTM();
		switch(msg->Msg_type()) {
		case darknet7::ESPToSTMAny_ESPSystemInfo: {
			MSGEvent<darknet7::ESPSystemInfo> mevt(msg->Msg_as_ESPSystemInfo(),msg->msgInstanceID());
			this->getBus().emitSignal(this,mevt);
			}
			break;
		case darknet7::ESPToSTMAny_CommunicationStatusResponse: {
			MSGEvent<darknet7::CommunicationStatusResponse> mevt(msg->Msg_as_CommunicationStatusResponse(),msg->msgInstanceID());
			this->getBus().emitSignal(this,mevt);
			}
			break;
		case darknet7::ESPToSTMAny_WiFiScanResults: {
			MSGEvent<darknet7::WiFiScanResults> mevt(msg->Msg_as_WiFiScanResults(),msg->msgInstanceID());
			this->getBus().emitSignal(this,mevt);
			}
			break;
		case darknet7::ESPToSTMAny_NPCList: {
			MSGEvent<darknet7::NPCList> mevt(msg->Msg_as_NPCList(),msg->msgInstanceID());
			this->getBus().emitSignal(this,mevt);
			}
			break;
		case darknet7::ESPToSTMAny_NPCInteractionResponse: {
			MSGEvent<darknet7::NPCInteractionResponse> mevt(msg->Msg_as_NPCInteractionResponse(),msg->msgInstanceID());
			this->getBus().emitSignal(this,mevt);
			}
			break;
		case darknet7::ESPToSTMAny_BadgesInArea: {
			MSGEvent<darknet7::BadgesInArea> mevt(msg->Msg_as_BadgesInArea(), msg->msgInstanceID());
			this->getBus().emitSignal(this, mevt);
			}
			break;
		case darknet7::ESPToSTMAny_BLESecurityConfirm: {
			MSGEvent<darknet7::BLESecurityConfirm> mevt(msg->Msg_as_BLESecurityConfirm(), msg->msgInstanceID());
			this->getBus().emitSignal(this, mevt);
			}
			break;
		case darknet7::ESPToSTMAny_BLEConnected: {
			MSGEvent<darknet7::BLEConnected> mevt(msg->Msg_as_BLEConnected(), msg->msgInstanceID());
			this->getBus().emitSignal(this, mevt);
			}
			break;
		case darknet7::ESPToSTMAny_BLEMessageFromDevice: {
			MSGEvent<darknet7::BLEMessageFromDevice> mevt(msg->Msg_as_BLEMessageFromDevice(), msg->msgInstanceID());
			this->getBus().emitSignal(this, mevt);
			}
			break;
		case darknet7::ESPToSTMAny_BLEPairingComplete: {
			MSGEvent<darknet7::BLEPairingComplete> mevt(msg->Msg_as_BLEPairingComplete(), msg->msgInstanceID());
			this->getBus().emitSignal(this, mevt);
			}
			break;
		case darknet7::ESPToSTMAny_BLEInfectionData: {
			MSGEvent<darknet7::BLEInfectionData> mevt(msg->Msg_as_BLEInfectionData(), msg->msgInstanceID());
			this->getBus().emitSignal(this, mevt);
			}
			break;
		default:
			break;
		}
		InComing.pop();
	}
}
