thedarknet/dc26-badge/firmware/esp-wroom-32/dc26-esp/main/npc_interact.h

#ifndef DARKNET7_NPC_INTERACT
#define DARKNET7_NPC_INTERACT

#include "esp_system.h"
#include "esp_log.h"
#include "lib/Task.h"
#include "freertos/queue.h"
#include "mcu_to_mcu.h"
#include <string.h>

class NPCInteractionTask : public Task {
public:
	struct NPCMsg {
		enum REQUEST_TYPE { NONE, HELO, INTERACT };
		REQUEST_TYPE RType;
		uint32_t MsgID;
		char NpcName[32];
		char Action[32];
		NPCMsg(const REQUEST_TYPE &r, uint32_t msgID) : RType(r), MsgID(msgID), NpcName(), Action() {}
		NPCMsg(const REQUEST_TYPE &r, uint32_t msgID, const char *name, const char *action) 
				  : RType(r), MsgID(msgID), NpcName(), Action() {
			if(name) {
				strcpy(&NpcName[0],name);
			} else {
				memset(&NpcName[0],0,sizeof(NpcName));
			}
			if(action) {
				strcpy(&Action[0],action);
			} else {
				memset(&Action[0],0,sizeof(Action));
			}
		}
	};
	static const int NPCMSG_QUEUE_SIZE = 10;
	static const int NPCMSG_ITEM_SIZE = sizeof(NPCInteractionTask::NPCMsg*);
	static const char *LOGTAG;
public:
	NPCInteractionTask(const std::string &tName, uint16_t stackSize=4196, uint8_t p=5);
	bool init();
	virtual void run(void *data);
	virtual ~NPCInteractionTask();
	QueueHandle_t getQueueHandle() { return InQueueHandle;}
private:
	QueueHandle_t InQueueHandle;
};

#endif
