thedarknet/dc26-badge/firmware/esp-wroom-32/dc26-esp/main/dc26_ble/services.h

#include "esp_system.h"
#include "esp_log.h"
#include "ble.h"

// Pairing and CISO/COSI (Client In/Server Out, Client Out/Server In)
#define PAIR_SERVICE_UUID  "64633236-6463-646e-3230-313870616972"
#define PAIRING_CISO_UUID  "646e0001-0001-0002-0003-000000000001"
#define PAIRING_COSI_UUID  "646e0001-0001-0002-0003-000000000002"
static BLEUUID uartServiceUUID(PAIR_SERVICE_UUID);
static BLEUUID uartCisoUUID(PAIRING_CISO_UUID);
static BLEUUID uartCosiUUID(PAIRING_COSI_UUID);
#define uartCisoCharProps (BLECharacteristic::PROPERTY_READ | \
							BLECharacteristic::PROPERTY_NOTIFY)
#define uartCosiCharProps (BLECharacteristic::PROPERTY_WRITE)
