thedarknet/dc26-badge/firmware/esp-wroom-32/dc26-esp/main/dc26.h

/*
 * dc26.h
 *
 *  Created on: Jul 10, 2018
 *      Author: cmdc0de
 */

#ifndef MAIN_DC26_H_
#define MAIN_DC26_H_

class MCUToMCUTask;
class BluetoothTask;
class DisplayTask;

MCUToMCUTask &getMCUToMCU();
BluetoothTask &getBLETask();
DisplayTask &getDisplayTask();

#endif /* MAIN_DC26_H_ */
