thedarknet/dc26-badge/firmware/DevBoard/darknet-7/Src/darknet/menus/sao_menu.h

/*
 * sao_menu.h
 *
 *  Created on: Jul 17, 2018
 *      Author: cmdc0de
 */

#ifndef DARKNET_MENUS_SAO_MENU_H_
#define DARKNET_MENUS_SAO_MENU_H_




#include "darknet7_base_state.h"


class SAO: public Darknet7BaseState {
public:
	enum INTERNAL_STATE {NONE, DISPLAY_SCANNING, SCANNING, INTERACTING };
	static const uint16_t NOADDRESS = 0xFFFF;
	SAO();
	virtual ~SAO();
protected:
	virtual cmdc0de::ErrorType onInit();
	virtual cmdc0de::StateBase::ReturnStateContext onRun();
	virtual cmdc0de::ErrorType onShutdown();
private:
	INTERNAL_STATE InternalState;
	uint16_t Address;
};




#endif /* DARKNET_MENUS_SAO_MENU_H_ */
