thedarknet/dc26-badge/firmware/DevBoard/darknet-7/Src/darknet/menus/tamagotchi.h

/*
 * tamagotchi.h
 *
 *  Created on: May 30, 2018
 *      Author: dcomes
 */

#ifndef DARKNET_MENUS_TAMAGOTCHI_H_
#define DARKNET_MENUS_TAMAGOTCHI_H_


#include "darknet7_base_state.h"


class Tamagotchi: public Darknet7BaseState {
public:
	Tamagotchi();
	virtual ~Tamagotchi();
protected:
	virtual cmdc0de::ErrorType onInit();
	virtual cmdc0de::StateBase::ReturnStateContext onRun();
	virtual cmdc0de::ErrorType onShutdown();
private:

};




#endif /* DARKNET_MENUS_TAMAGOTCHI_H_ */
