thedarknet/dc26-badge/firmware/DevBoard/darknet-7/Src/darknet/init.h

/*
 * init.h
 *
 *  Created on: Dec 3, 2017
 *      Author: dcomes
 */

#ifndef DARKNET_INIT_H_
#define DARKNET_INIT_H_


#ifdef __cplusplus
extern "C" {
#endif
	void init();
	void runOnce();
#ifdef __cplusplus
}
#endif



#endif /* DARKNET_INIT_H_ */
