thedarknet/dc26-badge/(commit log)

2017-12-03 initial project check in
    [InitDevBoard Debug.cfg]
2017-12-04 stating with new project
    [InitDevBoard Debug.cfg]
2017-12-04 added i2c
2017-12-07 initial board schema
    [STM32F411RET6.stl, STM32F411RET6.stp, dc26-dev-board.sch]
2017-12-11 WIP for board
    [dc26-dev-board.sch]
2017-12-12 power scheme done?
    [dc26-dev-board.sch]
2017-12-13 more docs, added GPIOs for SD_CS and APA104s scemea farther along
    [05_ESP_WROOM_S2_V2.0_bom.xls, ESP-WROOM-S2_SCHEMATIC_20170908A.DSN, ESP_WROOM_S2_V2.0.pcb, dc26-dev-board.sch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]
2017-12-18 all but breakouts are done (I think)
    [dc26-dev-board.sch]
2017-12-20 removing files that don't need to be there
    [05_ESP_WROOM_S2_V2.0_bom.xls, ESP-WROOM-S2_SCHEMATIC_20170908A.DSN, ESP_WROOM_S2_V2.0.pcb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]
2017-12-29 added ferrite bead updated VSS to go to gnd
    [BLM18TG221TN1D.stl, BLM18TG221TN1D.stp, Eagle.sch, dc26-dev-board.sch]
2017-12-30 changed caps to 8050 rather than 1205 per https://www.allaboutcircuits.com/technical-articles/clean-power-for-every-ic-part-2-choosing-and-using-your-bypass-capacitors/
    [dc26-dev-board.sch]
2017-12-31 all errors gone from schema
    [LD39050PU33R.stl, LD39050PU33R.stp, dc26-dev-board.sch]
2017-12-31 added a user button and a button to reset
    [dc26-dev-board.sch]
2018-01-01 ready for review again.
    [dc26-dev-board.sch]
2018-01-01 swapped out voltage regulator for one that supports 1A rather than just .5A
    [LD39100PU33RY.stl, LD39100PU33RY.stp, dc26-dev-board.sch]
2018-01-02 inital board layout
    [dc26-dev-board.brd, dc26-dev-board.sch]
2018-01-02 first auto route
    [dc26-dev-board.brd]
2018-01-02 auto routed boardwith some minor vcc changes by hand.
    [dc26-dev-board.brd, dc26-dev-board.sch]
2018-01-03 minor fixed of part naming and added todo file
    [dc26-dev-board.brd, dc26-dev-board.sch]
2018-01-04 added R9 to crystal moved logo and DN to tslik and bsilk layers
    [dc26-dev-board.brd, dc26-dev-board.sch]
2018-01-04 Autoroute (#1)
    * inital board layout
    * first auto route
    * auto routed boardwith some minor vcc changes by hand.
    * minor fixed of part naming and added todo file
    * added R9 to crystal
    moved logo and DN to tslik and bsilk layers
    [dc26-dev-board.brd, dc26-dev-board.sch]
2018-01-04 add debug config file
    [DC26 Debug.cfg]
2018-03-19 Board2 - (#2)
    * initial code compiling for esp32
    * adding files
    * more updates see last sheet for details
    * added apa102
    * started routing of devboard2
    * power run not but not gpio
    * after chatting with bunni
    * fixed all board errors except air wires
    * ran power to apa102
    * fixed an overlap
    moved logos onto board
    * board sent to oshpark
    [dc26-dev-board-apa102c.brd, dc26-dev-board-apa102c.sch, dc26-dev-board.brd, dc26-dev-board.sch]
2018-03-26 adding base project to new devboard project from nucelo board
    [darknet-7 Debug.cfg, dc26-dev-board-apa102c-3.brd, dc26-dev-board-apa102c-3.sch]
2018-04-09 compiles start of spi test
2018-04-14 adding initial spi test
2018-04-15 testing spi
2018-04-16 tried I2C....but even esp-idf example does not work!
2018-04-16 adding uart code
2018-04-16 basic communication between stm and esp working via uart1
2018-04-17 adding new LDO part
    [LDL112D33R.stl, LDL112D33R.stp]
2018-04-18 updated board schema version 3
    [dc26-dev-boardv3.sch]
2018-04-19 added new tvs diode after talking with bunni even made the part myself
    [dc26-dev-boardv3.sch]
2018-04-25 dc26-'final' board ready
    [dc26.brd, dc26.sch]
2018-04-25 logo causing 0 width polys will fix later
    [dc26.brd, dc26.sch]
2018-04-28 added logo to library added logos to board
    [dc26.brd, dc26.sch]
2018-04-30 updated board
    [dc26.brd, dc26.sch]
2018-05-12 libesphttp now checked in compiles and works with esp32 build system
2018-05-13 fatfs now works
    [partitions.csv]
2018-05-17 led 3 is now controlled via esp32 rather than STM
    [dc26.brd, dc26.sch]
2018-05-17 increased the size of the apa106f5 wholes updated ratsnet
    [dc26.brd, dc26.sch]
2018-05-20 Added art work, fixed via drills, and started some initial trace cleanup. Still need to move Cmdc0de/Krux logos into place.
    [dc26.brd, dc26.sch]
2018-05-20 updated led 3mm with a smaller name and value
    [dc26.brd, dc26.sch]
2018-05-21 turing off sd card since for some reason the test board will not turn on the clk signal. Not sure if this a software problem or did I do something to the chip when I soliders it on
    [DC26.cpp, darknet-7.ioc, fat_sd_spi.c]
2018-05-21 clean up of silk screen and artwork
    [dc26.brd, dc26.sch]
2018-05-21 chainge first code segment to only be 16K instead of 32K giving us more space for user data
2018-05-22 Fixed airwires
    [dc26.brd]
2018-05-22 enbiggened the trace from the lipo
    [dc26.brd]
2018-05-23 Updated trace behind front art
    [dc26.brd]
2018-05-23 Always RUN DRC
    [dc26.brd]
2018-05-24 moved uart task to a cpp Task
2018-05-24 all but my puzzel is complete,
    [dc26.brd]
2018-05-27 Initial demo using the CPP BLE Stack with max data usage.
    Device Name: GOURRY!!!!
    Manufacturer Data: EGGPLANTS
    [partitions.csv]
2018-05-27 Initial demo using the CPP BLE Stack with max data usage. (#26)
    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
    [partitions.csv]
2018-05-27 Dc26 badge to badge (#27)
    * Initial demo using the CPP BLE Stack with max data usage.
    * start of bluetooth command structure, implement updating advertised badge name and manufacturer data
    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
2018-05-27 Convert BLE to Task and add .init() fix for command_handler
    [dc26.cpp, dc26_ble_proto.cpp, dc26_ble_proto.h]
2018-05-28 flash handling updated for stm32f411 proc
2018-05-29 adding all the files I missed
    [AddressState.cpp, AddressState.h, SendMsgState.cpp, SendMsgState.h, badge_info_state.cpp, badge_info_state.h, communications_settings.cpp, communications_settings.h]
2018-05-30 one way comms, i think the tasks are preventing preemption and therefore message delivery, will convert to no tasks at all
    [dc26_ble.cpp, dc26_ble.h, dc26_ble_pairing_server.cpp, dc26_ble_pairing_server.h, dc26_ble_scanning.cpp]
2018-05-31 progress, but still failing to receive a notification.
    [dc26_ble.cpp, dc26_ble.h, dc26_ble_pairing_server.cpp, dc26_ble_pairing_server.h]
2018-06-01 realized there is already a message type so removed the redundant one added a message instance id added switch statement in uart handler to seed the code that will route messages
2018-06-02 testing queues, does not work, xQueueReceive never returns true, despite xQueueSendFromISR successfully placing the item on the queue
    [dc26_ble.cpp, dc26_ble.h]
2018-06-03 set current state in init
2018-06-03 updated button handling
2018-06-03 removed vin from esp and stm32 programer headers you will need to have battery connected to program
    [dc26.brd]
2018-06-05 start of security stuff. Fix a bug with pure-virtual destructor in BLESecurity.h. Super annoying
    [ble.cpp, security.h]
2018-06-05 adding real data sheet for switch
    [dc26.brd, dc26.sch]
2018-06-05 Updated artwork silkscreen polygon width to 0.1016mm (minimum size by Seeed)
    [dc26.brd, dc26.sch]
2018-06-17 basics of sd card working still have work todo to get flatbuffers working Buttons now working
    [dc26.brd, dc26.sch]
2018-06-17 security not working, but at least IO works for now
    [ble.cpp, ble.h, pairing_client.cpp]
2018-06-18 Dc26 badge to badge (#28)
    * Convert BLE to Task and add .init() fix for command_handler
    * Add passive and active scanning. Also apparently pairing works auto-magically!
    * BT: Start of badge-to-badge comms
    * sdkconfig
    * restructuring. non-functional at the moment
    * one way comms, i think the tasks are preventing preemption and therefore message delivery, will convert to no tasks at all
    * progress, but still failing to receive a notification.
    * bas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
    [ble.cpp, ble.h, dc26.cpp, dc26_ble_proto.cpp, dc26_ble_proto.h, pairing_client.cpp, pairing_server.h, scanning.cpp]
2018-06-18 fixed flatbuffer serialization in test code
    [darknet7.cpp]
2018-07-14 start of final API re-format. NOT TESTED, PROBABLY DOESN'T COMPILE
    [ble.cpp, ble.h, scanning.cpp, scanning.h]
2018-07-15 flatbuffers built, esp builds. NOT TESTED, WILL ALMOST CERTAINLY CRASH
    [ble.cpp, scanning.cpp]
2018-07-15 broken test, not sure i'm creating the flatbuffer correctly
    [ble.cpp]
2018-07-15 broken creation of a Message object, not sure how to fix
    [ble.cpp, mcu_to_mcu.h]
2018-07-16 fixing compile errors in ble y
    [ble.cpp]
2018-07-17 move filter enum to common, re-generated files, add exposure stubs
2018-07-17 Added board design files and code for Eggplant SAO
    [eggplant-BOM.xls, eggplant.brd, eggplant.sch]
2018-07-18 get security PIN passing working and simplify soem files
2018-07-18 started IO, question - can the data we are sending contain NULL bytes? Or can we format into ASCII before sending to avoid this?
    [ble.cpp, pairing.cpp, pairing.h]
2018-07-18 io testing. no secondary callback layers, those queues were remoted. One problem: 20 byte limit per notification. Send multiple?
    [ble.cpp, ble.h, pairing.cpp, services.h]
2018-07-18 Notes on I2C on ATTiny
2018-07-23 basic shitty add on badge working, test state now works completely, bunch of small bug fixes
    [badge_info_state.cpp, darknet7.cpp, darknet7.h, menu_state.cpp, menu_state.h, sao_menu.cpp, sao_menu.h, test_state.cpp]
2018-07-25 make mid consistent and fixed a bug with entry of BLE name
    [communications_settings.cpp, mcu_info.cpp]
2018-07-28 fixed another mcu to mcu bug, scanning for NPCs now works
    [mcu_to_mcu.cpp, scan.cpp]
2018-07-28 logos didn't really work
    [darknet7.cpp, scan.cpp]
2018-07-29 fixed mem leak in i2c code
    [dc26.cpp, display_handler.cpp]
2018-07-29 Start some progress on the badge pairing code. Should be able to send request to scan, and receive, but not parsing the receive message. Also not handling a timeout at the moment.
    [darknet-7 Debug.cfg]
2018-07-30 start of badge pairing menu. Scans and finds a thing, but fails to display
    [pairing_state.cpp]
2018-07-31 pushing prog button now turns on second non programmable LED
2018-08-02 simplify further, one last try at a fix
    [pairing_state.cpp, pairing_state.h]
2018-08-02 try one last time with short message, but nope, that didn't work either, ugh
    [pairing_state.cpp]
2018-08-03 Put the crypto stuff in place, but I need to fill the fields with real stuff for it to actually work correctly, also the address book is not implemented
    [pairing_state.cpp]
2018-08-04 fixed display of logos, most of code needed for npc interaction
    [command_handler.cpp, command_handler.h, darknet7.cpp, npc_interact.cpp, npc_interact.h]
2018-08-04 pairing all occurs in one menu
    [used_keys.csv]
2018-08-04 forcibly stop scanning if we're the server receiving a security request before we request a pin confirmation. This kills the gourry.
2018-08-05 bob and alice pair and store each others contact info correctly! Agents must BOTH be in the badge pairing menu -- todo: handle pair attempts where the other agent is outside the pairing menu. handle 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
    [menu_state.cpp, pairing_state.cpp]
2018-08-05 change device name when agent changes their name or when they change the advertised name.
2018-08-05 removing keys
    [used_keys.csv]
2018-08-05 stm pairing is stable now, but the ESP still crashes if people try to pair a second time. nvs_flash_erase has been put back in place for ESP reboot to help this.
    [ble.cpp, dc26.cpp, pairing.cpp, pairing.h, pairing_state.cpp, security.cpp, security.h]
2018-08-05 bigger font. don't merge this i'm not convinced it's not causing the esp crash problem
    [ble.cpp, dc26.cpp, display_handler.cpp, pairing.cpp]
2018-08-06 PAIRING WORKS. Reduced glut in the ble task to make space for heap, reduced the display handler stack to 4000 (doesn't seem like it should need much).
    [ble.cpp, ble.h, ble_serial.cpp, ble_serial.h, display_handler.h, pairing.cpp, pairing.h, scanning.cpp]
2018-08-06 no longer erase nvs flash
    [dc26.cpp]
2018-08-07 npc bssid filter in place must start with 0xdcd
2018-08-07 fixed initialize of infections
    [KeyStore.cpp]
2018-08-07 fixed displays fixed delay on npc interact
    [ble.cpp, scan.cpp]
2018-08-07 correct infection bits over adverts
    [KeyStore.cpp]
2018-08-07 hack fix for uart communication
    [darknet7.cpp]
2018-08-11 fix for badge pairing
    [ble.cpp]
