thedarknet/dc26-badge/(notices)

Notices in the files:
firmware/DevBoard/darknet-7/Inc/main.h:
Copyright (c) 2018 STMicroelectronics International N.V.
All rights reserved.
(C) COPYRIGHT STMicroelectronics *****END OF FILE
parts and their libraries:
SparkFun: Licensing: CC v3.0 Share-Alike You are welcome to use this library for commercial purposes.
